ARMmbed/fpga-ci-test-shield-hardware/README.md

# FPGA CI Test shield - hardware design

Note: the RTL code for the FPGA lives in a separate repository: https://github.com/ARMmbed/fpga-ci-test-shield
