ARMmbed/fpga-ci-test-shield-hardware/doc/Documentation Slides.pptx

Upper position to run FPGA at 3V3. Lower position for 1.8V

Upper Position for USB,
Lower Position for External 5V

5 Jumpers fitted to supply power to the board

## Slide 2

3V3 Rail

1V0 Rail

1V8 Rail

## Slide 3

Jumper Positioning for External Programming

## Slide 4

Arduino Breakout board

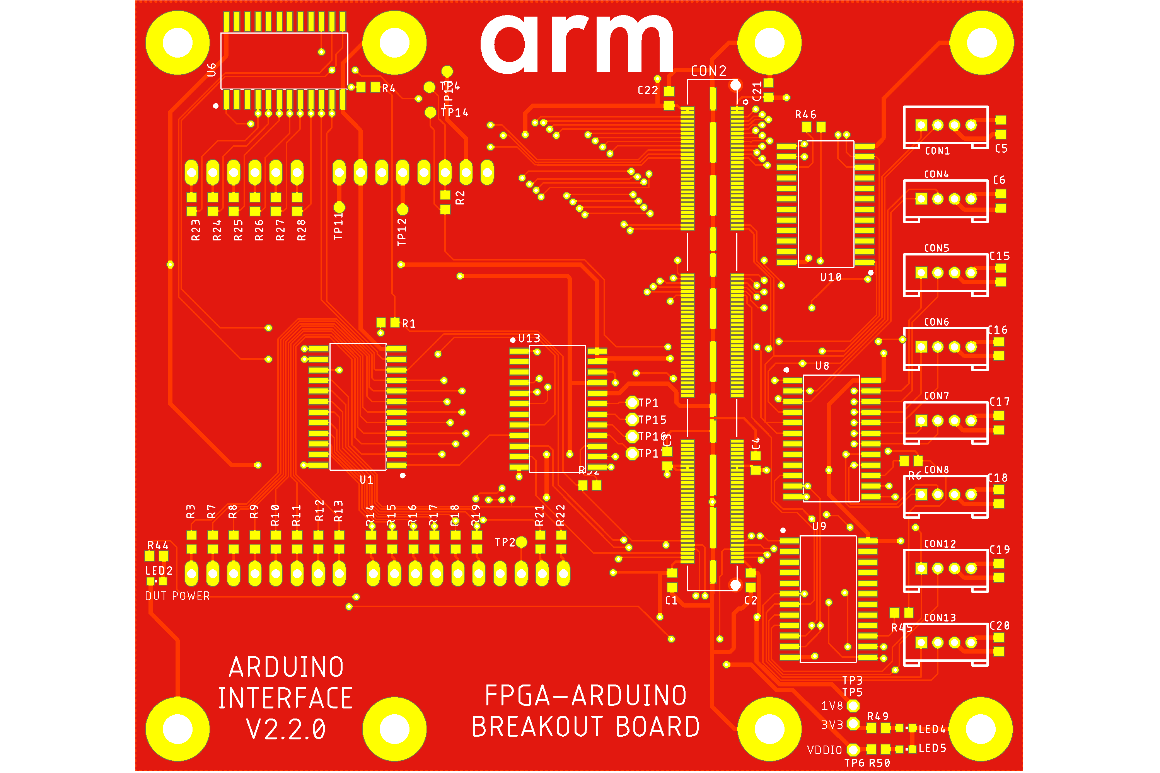
[picture p1: figure]

FPGA Board Interconnect

IO21
IO20
IO19
IO18
IO17
IO16

Arduino Form-Factor Pins (underside)

Grove connectors available for additional connectivity as required
(IO52 – IO64)

IO8
IO9
IO10
IO11
IO12
IO13
IO14
IO15

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
## Slide 5

Validation Board

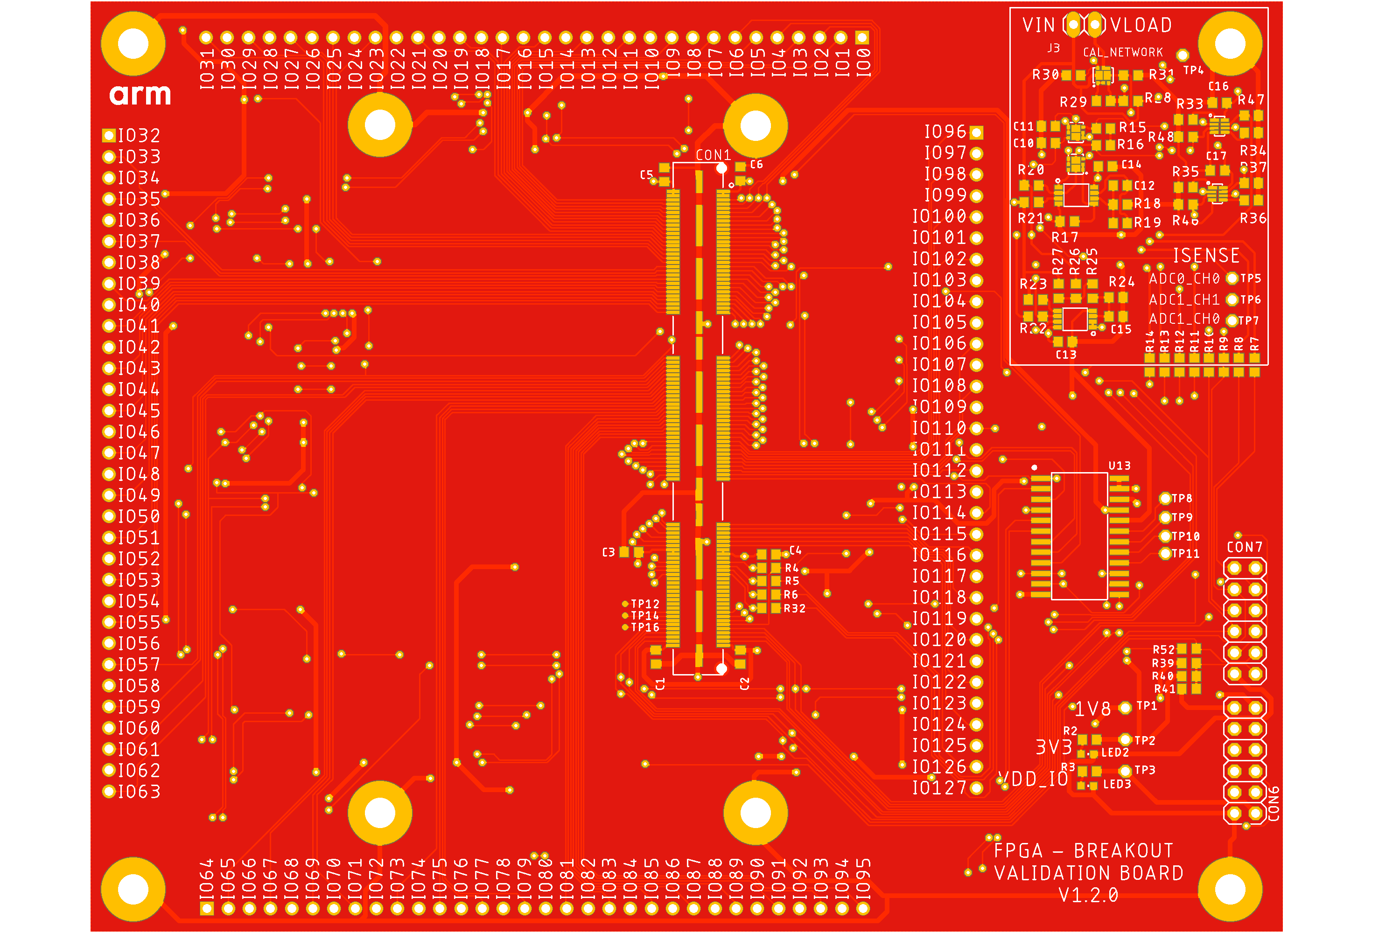
[picture p2: figure]

FPGA Board Interconnect

All IO brought out
to individual pins for monitoring and test

I Sense (for future development)

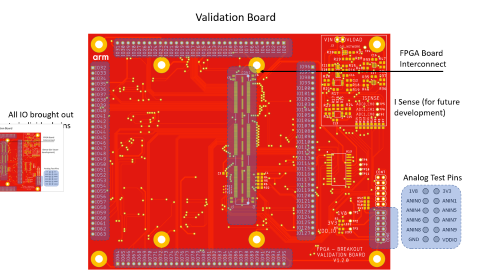
[picture p3: figure]

Analog Test Pins

ANIN0

1V8

ANIN1

3V3

ANIN4

ANIN6

ANIN8

ANIN5

ANIN7

ANIN9

GND

VDDIO
