ARMmbed/fpga-ci-test-shield-hardware/connectors/arduino/FPGA-ArduinoR3.brd

## EAGLE design connectors/arduino/FPGA-ArduinoR3.brd (2021-01-28)

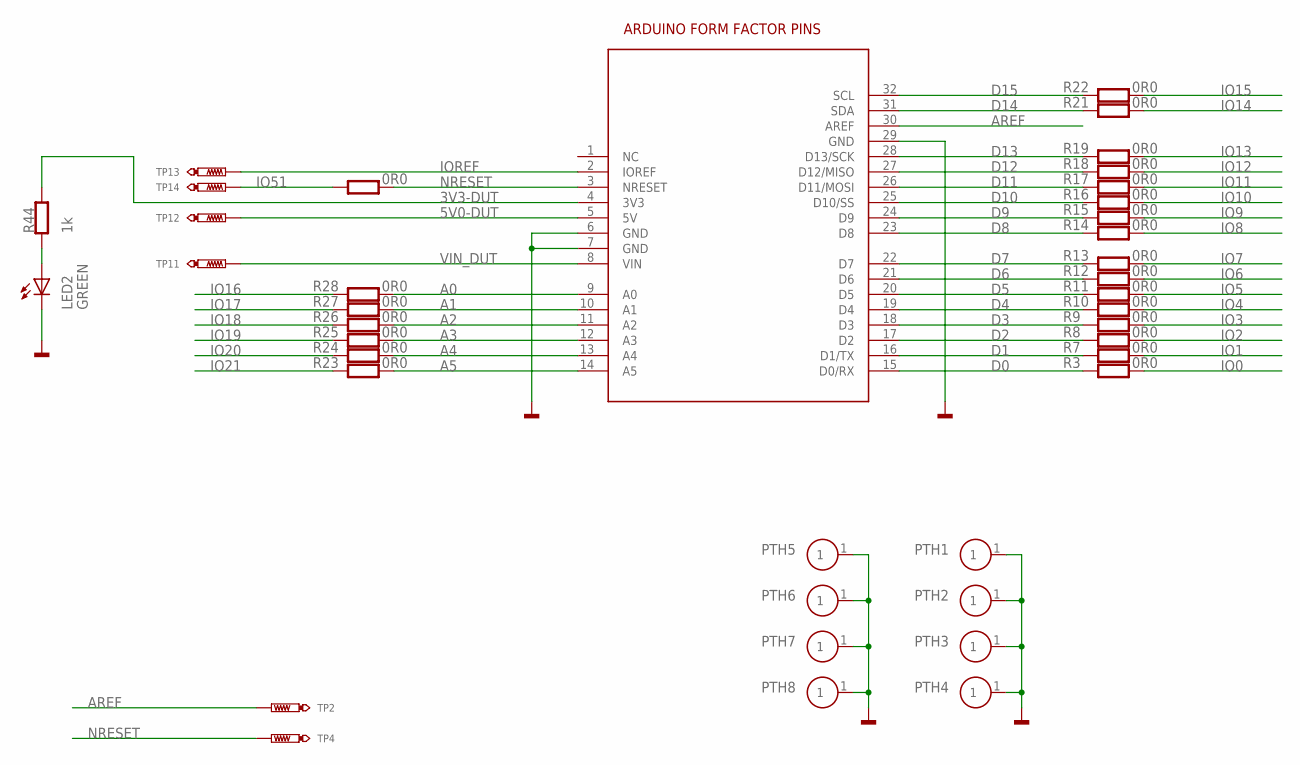
[picture p4: schematic FPGA-ArduinoR3.sch, sheet 1]

Parts:
BRD1: ARDUINO-R3_SILK; ARDUINO-R3-SILK
LED2: GREEN; CHIPLED_0603
PTH1, PTH2, PTH3, PTH4, PTH5, PTH6, PTH7, PTH8: FIXINGHOLE; PTH-140-300
R2, R3, R7, R8, R9, R10, R11, R12, R13, R14, R15, R16, R17, R18, R19, R21, R22, R23, R24, R25, R26, R27, R28: 0R0; 0603
R44: 1k; 0603
TP2, TP4, TP11, TP12, TP13, TP14: TEST_POINT-50R-SMD; TP50-SMD

Connections:
3V3-DUT: BRD1.4 (3V3), R44.2
5V0-DUT: BRD1.5 (5V), TP12.TP
A0: BRD1.9 (A0), R28.1
A1: BRD1.10 (A1), R27.1
A2: BRD1.11 (A2), R26.1
A3: BRD1.12 (A3), R25.1
A4: BRD1.13 (A4), R24.1
A5: BRD1.14 (A5), R23.1
AREF: BRD1.30 (AREF), TP2.TP
D0: BRD1.15 (D0/RX), R3.2
D1: BRD1.16 (D1/TX), R7.2
D2: BRD1.17 (D2), R8.2
D3: BRD1.18 (D3), R9.2
D4: BRD1.19 (D4), R10.2
D5: BRD1.20 (D5), R11.2
D6: BRD1.21 (D6), R12.2
D7: BRD1.22 (D7), R13.2
D8: BRD1.23 (D8), R14.2
D9: BRD1.24 (D9), R15.2
D10: BRD1.25 (D10/SS), R16.2
D11: BRD1.26 (D11/MOSI), R17.2
D12: BRD1.27 (D12/MISO), R18.2
D13: BRD1.28 (D13/SCK), R19.2
D14: BRD1.31 (SDA), R21.2
D15: BRD1.32 (SCL), R22.2
GND: BRD1.6 (GND), BRD1.7 (GND), BRD1.29 (GND), LED2.C, PTH1.1, PTH2.1, PTH3.1, PTH4.1, PTH5.1, PTH6.1, PTH7.1, PTH8.1; also elsewhere on the board
IO0: R3.1; also elsewhere on the board
IO1: R7.1; also elsewhere on the board
IO2: R8.1; also elsewhere on the board
IO3: R9.1; also elsewhere on the board
IO4: R10.1; also elsewhere on the board
IO5: R11.1; also elsewhere on the board
IO6: R12.1; also elsewhere on the board
IO7: R13.1; also elsewhere on the board
IO8: R14.1; also elsewhere on the board
IO9: R15.1; also elsewhere on the board
IO10: R16.1; also elsewhere on the board
IO11: R17.1; also elsewhere on the board
IO12: R18.1; also elsewhere on the board
IO13: R19.1; also elsewhere on the board
IO14: R21.1; also elsewhere on the board
IO15: R22.1; also elsewhere on the board
IO16: R28.2; also elsewhere on the board
IO17: R27.2; also elsewhere on the board
IO18: R26.2; also elsewhere on the board
IO19: R25.2; also elsewhere on the board
IO20: R24.2; also elsewhere on the board
IO21: R23.2; also elsewhere on the board
IO51: R2.2, TP14.TP; also elsewhere on the board
IOREF: BRD1.2 (IOREF), TP13.TP
unnamed: LED2.A, R44.1
NRESET: BRD1.3 (NRESET), R2.1, TP4.TP
VIN_DUT: BRD1.8 (VIN), TP11.TP

Notes on the sheet:
ARDUINO FORM FACTOR PINS

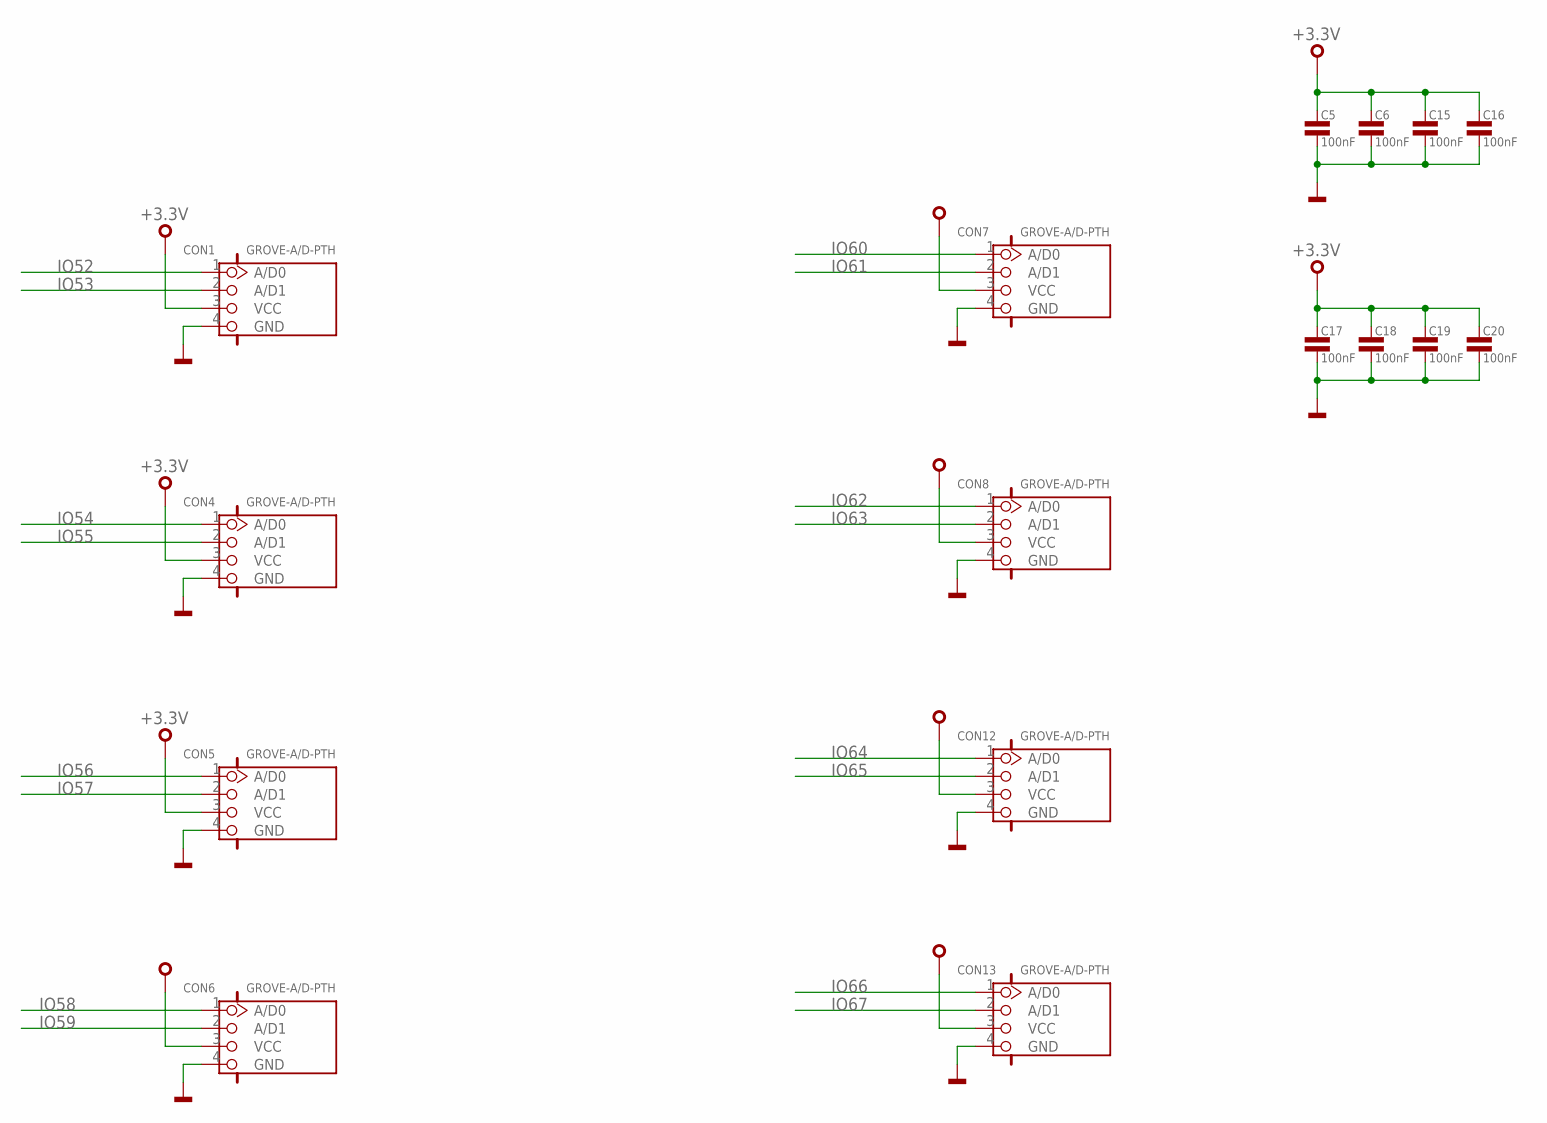
[picture p5: schematic FPGA-ArduinoR3.sch, sheet 2]

Parts:
C5, C6, C15, C16, C17, C18, C19, C20: 100nF; 0603
CON1, CON4, CON5, CON6, CON7, CON8, CON12, CON13: GROVE-A/D-PTH; HW4-2.0

Connections:
+3.3V: C5.1, C6.1, C15.1, C16.1, C17.1, C18.1, C19.1, C20.1, CON1.3 (VCC), CON4.3 (VCC), CON5.3 (VCC), CON6.3 (VCC), CON7.3 (VCC), CON8.3 (VCC), CON12.3 (VCC), CON13.3 (VCC); also elsewhere on the board
GND: C5.2, C6.2, C15.2, C16.2, C17.2, C18.2, C19.2, C20.2, CON1.4 (GND), CON4.4 (GND), CON5.4 (GND), CON6.4 (GND), CON7.4 (GND), CON8.4 (GND), CON12.4 (GND), CON13.4 (GND); also elsewhere on the board
IO52: CON1.1 (A/D0); also elsewhere on the board
IO53: CON1.2 (A/D1); also elsewhere on the board
IO54: CON4.1 (A/D0); also elsewhere on the board
IO55: CON4.2 (A/D1); also elsewhere on the board
IO56: CON5.1 (A/D0); also elsewhere on the board
IO57: CON5.2 (A/D1); also elsewhere on the board
IO58: CON6.1 (A/D0); also elsewhere on the board
IO59: CON6.2 (A/D1); also elsewhere on the board
IO60: CON7.1 (A/D0); also elsewhere on the board
IO61: CON7.2 (A/D1); also elsewhere on the board
IO62: CON8.1 (A/D0); also elsewhere on the board
IO63: CON8.2 (A/D1); also elsewhere on the board
IO64: CON12.1 (A/D0); also elsewhere on the board
IO65: CON12.2 (A/D1); also elsewhere on the board
IO66: CON13.1 (A/D0); also elsewhere on the board
IO67: CON13.2 (A/D1); also elsewhere on the board

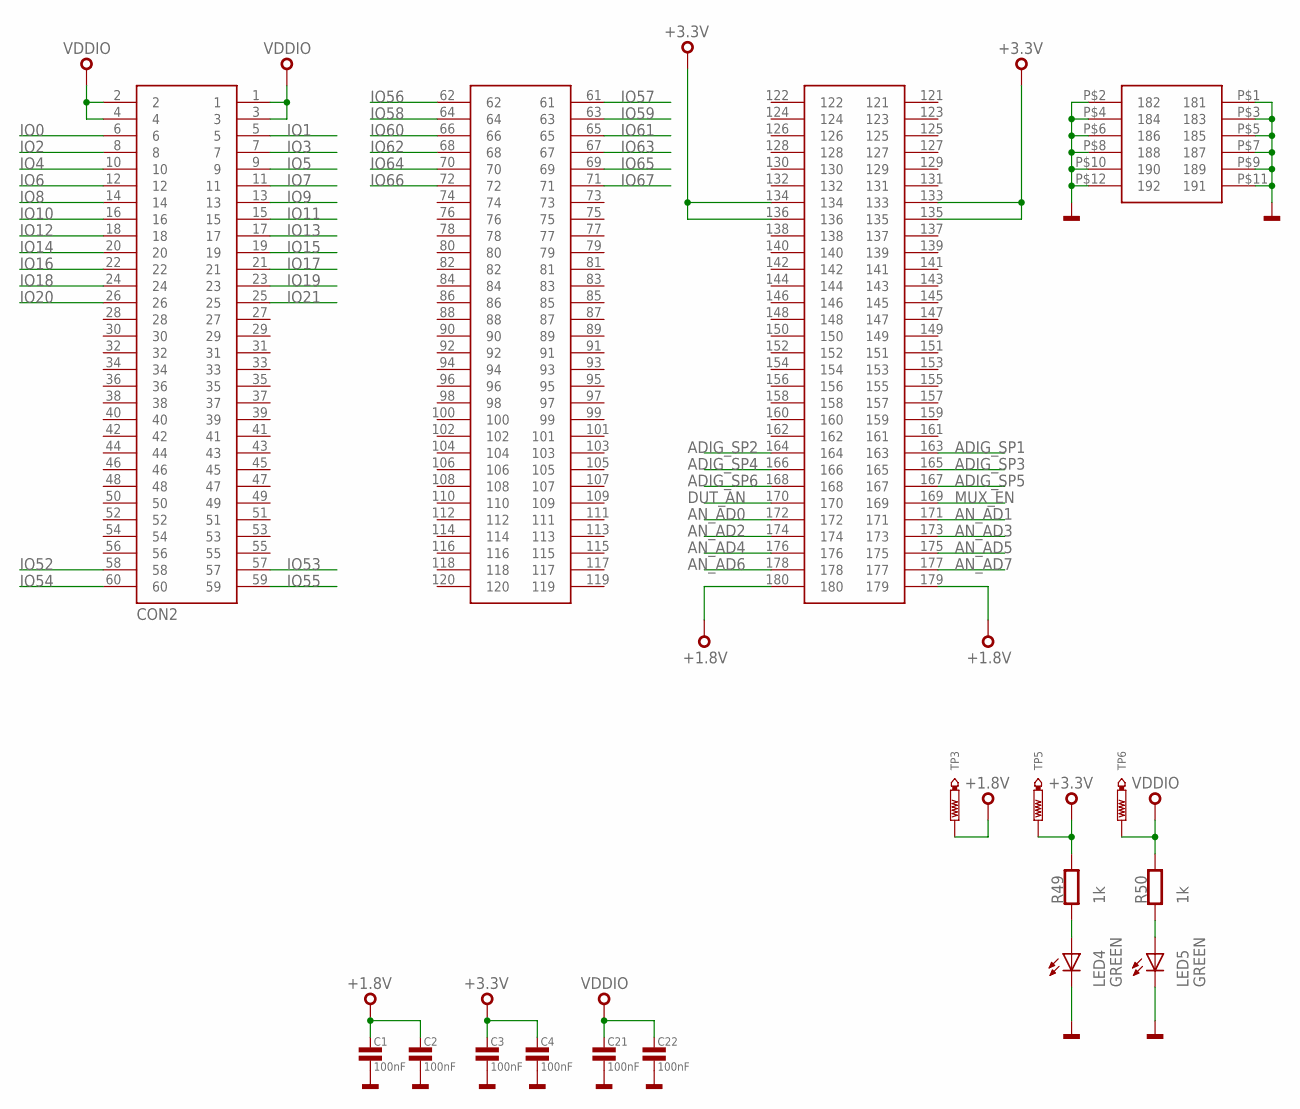
[picture p6: schematic FPGA-ArduinoR3.sch, sheet 3]

Parts:
C1, C2, C3, C4, C21, C22: 100nF; 0603
CON2: QSH-090-01-L-D-A
LED4, LED5: GREEN; CHIPLED_0603
R49, R50: 1k; 0603
TP3, TP5, TP6: TEST_POINT-50R-PTH; TP50-PTH

Connections:
+1.8V: C1.1, C2.1, CON2.179, CON2.180, TP3.TP; also elsewhere on the board
+3.3V: C3.1, C4.1, CON2.133, CON2.134, CON2.135, CON2.136, R49.2, TP5.TP; also elsewhere on the board
ADIG_SP1: CON2.163
ADIG_SP2: CON2.164
ADIG_SP3: CON2.165
ADIG_SP4: CON2.166
ADIG_SP5: CON2.167
ADIG_SP6: CON2.168
AN_AD0: CON2.172; also elsewhere on the board
AN_AD1: CON2.171; also elsewhere on the board
AN_AD2: CON2.174; also elsewhere on the board
AN_AD3: CON2.173; also elsewhere on the board
AN_AD4: CON2.176; also elsewhere on the board
AN_AD5: CON2.175; also elsewhere on the board
AN_AD6: CON2.178; also elsewhere on the board
AN_AD7: CON2.177; also elsewhere on the board
DUT_AN: CON2.170; also elsewhere on the board
GND: C1.2, C2.2, C3.2, C4.2, C21.2, C22.2, CON2.P$1 (181), CON2.P$2 (182), CON2.P$3 (183), CON2.P$4 (184), CON2.P$5 (185), CON2.P$6 (186), CON2.P$7 (187), CON2.P$8 (188), CON2.P$9 (189), CON2.P$10 (190), CON2.P$11 (191), CON2.P$12 (192), LED4.C, LED5.C; also elsewhere on the board
IO0: CON2.6; also elsewhere on the board
IO1: CON2.5; also elsewhere on the board
IO2: CON2.8; also elsewhere on the board
IO3: CON2.7; also elsewhere on the board
IO4: CON2.10; also elsewhere on the board
IO5: CON2.9; also elsewhere on the board
IO6: CON2.12; also elsewhere on the board
IO7: CON2.11; also elsewhere on the board
IO8: CON2.14; also elsewhere on the board
IO9: CON2.13; also elsewhere on the board
IO10: CON2.16; also elsewhere on the board
IO11: CON2.15; also elsewhere on the board
IO12: CON2.18; also elsewhere on the board
IO13: CON2.17; also elsewhere on the board
IO14: CON2.20; also elsewhere on the board
IO15: CON2.19; also elsewhere on the board
IO16: CON2.22; also elsewhere on the board
IO17: CON2.21; also elsewhere on the board
IO18: CON2.24; also elsewhere on the board
IO19: CON2.23; also elsewhere on the board
IO20: CON2.26; also elsewhere on the board
IO21: CON2.25; also elsewhere on the board
IO52: CON2.58; also elsewhere on the board
IO53: CON2.57; also elsewhere on the board
IO54: CON2.60; also elsewhere on the board
IO55: CON2.59; also elsewhere on the board
IO56: CON2.62; also elsewhere on the board
IO57: CON2.61; also elsewhere on the board
IO58: CON2.64; also elsewhere on the board
IO59: CON2.63; also elsewhere on the board
IO60: CON2.66; also elsewhere on the board
IO61: CON2.65; also elsewhere on the board
IO62: CON2.68; also elsewhere on the board
IO63: CON2.67; also elsewhere on the board
IO64: CON2.70; also elsewhere on the board
IO65: CON2.69; also elsewhere on the board
IO66: CON2.72; also elsewhere on the board
IO67: CON2.71; also elsewhere on the board
MUX_EN: CON2.169; also elsewhere on the board
unnamed: LED4.A, R49.1
unnamed: LED5.A, R50.1
VDDIO: C21.1, C22.1, CON2.1, CON2.2, CON2.3, CON2.4, R50.2, TP6.TP; also elsewhere on the board

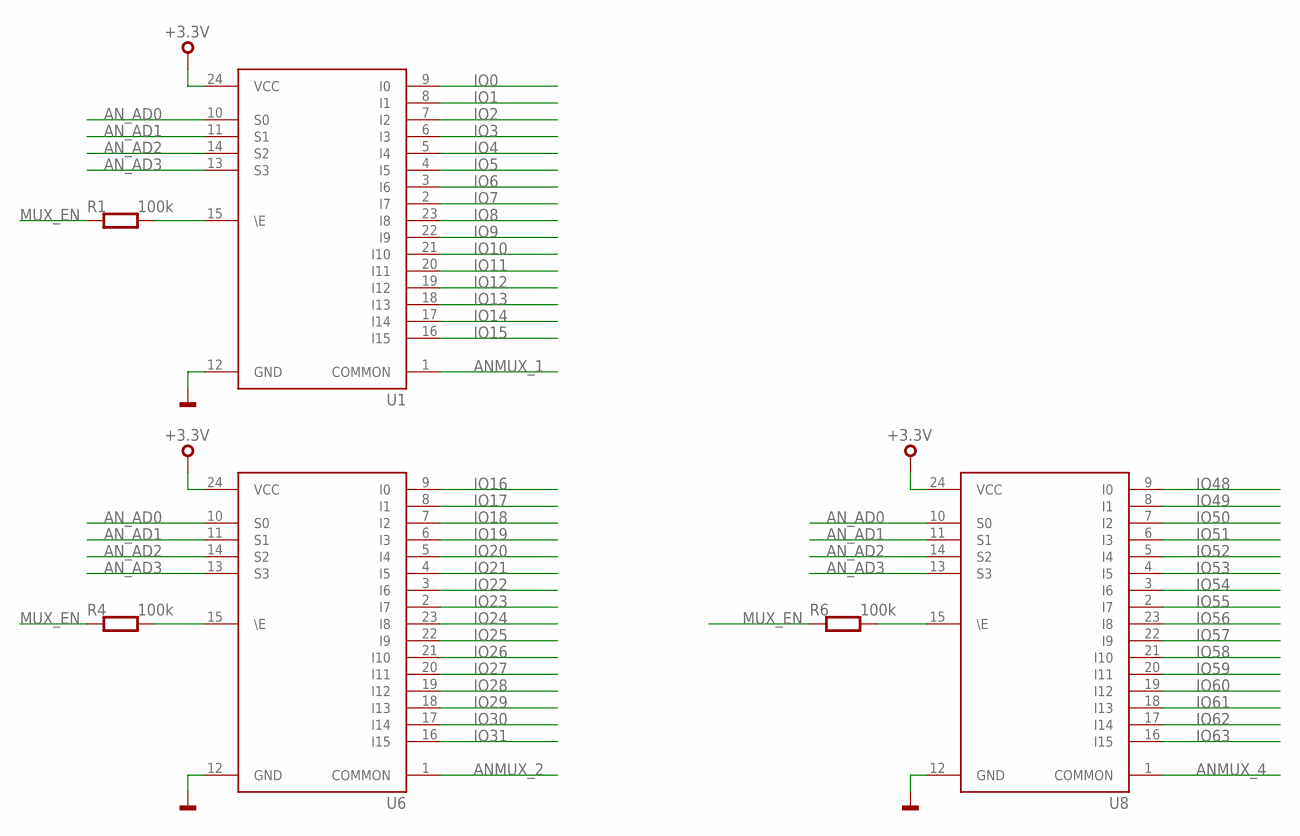
[picture p7: schematic FPGA-ArduinoR3.sch, sheet 4]

Parts:
R1, R4, R6: 100k; 0603
U1, U6, U8: CD74HCT4067; SO24

Connections:
+3.3V: U1.24 (VCC), U6.24 (VCC), U8.24 (VCC); also elsewhere on the board
ANMUX_1: U1.1 (COMMON); also elsewhere on the board
ANMUX_2: U6.1 (COMMON); also elsewhere on the board
ANMUX_4: U8.1 (COMMON); also elsewhere on the board
AN_AD0: U1.10 (S0), U6.10 (S0), U8.10 (S0); also elsewhere on the board
AN_AD1: U1.11 (S1), U6.11 (S1), U8.11 (S1); also elsewhere on the board
AN_AD2: U1.14 (S2), U6.14 (S2), U8.14 (S2); also elsewhere on the board
AN_AD3: U1.13 (S3), U6.13 (S3), U8.13 (S3); also elsewhere on the board
GND: U1.12 (GND), U6.12 (GND), U8.12 (GND); also elsewhere on the board
IO0: U1.9 (I0); also elsewhere on the board
IO1: U1.8 (I1); also elsewhere on the board
IO2: U1.7 (I2); also elsewhere on the board
IO3: U1.6 (I3); also elsewhere on the board
IO4: U1.5 (I4); also elsewhere on the board
IO5: U1.4 (I5); also elsewhere on the board
IO6: U1.3 (I6); also elsewhere on the board
IO7: U1.2 (I7); also elsewhere on the board
IO8: U1.23 (I8); also elsewhere on the board
IO9: U1.22 (I9); also elsewhere on the board
IO10: U1.21 (I10); also elsewhere on the board
IO11: U1.20 (I11); also elsewhere on the board
IO12: U1.19 (I12); also elsewhere on the board
IO13: U1.18 (I13); also elsewhere on the board
IO14: U1.17 (I14); also elsewhere on the board
IO15: U1.16 (I15); also elsewhere on the board
IO16: U6.9 (I0); also elsewhere on the board
IO17: U6.8 (I1); also elsewhere on the board
IO18: U6.7 (I2); also elsewhere on the board
IO19: U6.6 (I3); also elsewhere on the board
IO20: U6.5 (I4); also elsewhere on the board
IO21: U6.4 (I5); also elsewhere on the board
IO22: U6.3 (I6)
IO23: U6.2 (I7)
IO24: U6.23 (I8)
IO25: U6.22 (I9)
IO26: U6.21 (I10)
IO27: U6.20 (I11)
IO28: U6.19 (I12)
IO29: U6.18 (I13)
IO30: U6.17 (I14)
IO31: U6.16 (I15)
IO48: U8.9 (I0)
IO49: U8.8 (I1)
IO50: U8.7 (I2)
IO51: U8.6 (I3); also elsewhere on the board
IO52: U8.5 (I4); also elsewhere on the board
IO53: U8.4 (I5); also elsewhere on the board
IO54: U8.3 (I6); also elsewhere on the board
IO55: U8.2 (I7); also elsewhere on the board
IO56: U8.23 (I8); also elsewhere on the board
IO57: U8.22 (I9); also elsewhere on the board
IO58: U8.21 (I10); also elsewhere on the board
IO59: U8.20 (I11); also elsewhere on the board
IO60: U8.19 (I12); also elsewhere on the board
IO61: U8.18 (I13); also elsewhere on the board
IO62: U8.17 (I14); also elsewhere on the board
IO63: U8.16 (I15); also elsewhere on the board
MUX_EN: R1.1, R4.1, R6.1; also elsewhere on the board
unnamed: R4.2, U6.15 (\E)
unnamed: R1.2, U1.15 (\E)
unnamed: R6.2, U8.15 (\E)

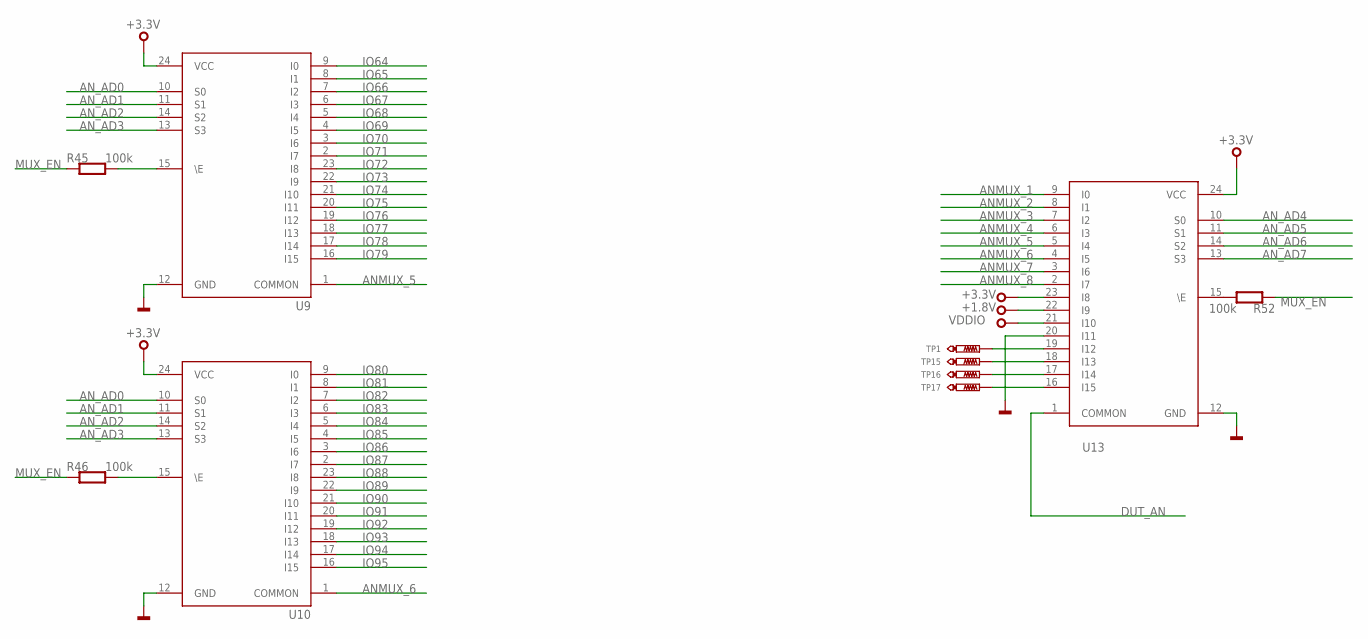
[picture p8: schematic FPGA-ArduinoR3.sch, sheet 5]

Parts:
R45, R46, R52: 100k; 0603
TP1, TP15, TP16, TP17: TEST_POINT-50R-PTH; TP50-PTH
U9, U10, U13: CD74HCT4067; SO24

Connections:
+1.8V: U13.22 (I9); also elsewhere on the board
+3.3V: U9.24 (VCC), U10.24 (VCC), U13.23 (I8), U13.24 (VCC); also elsewhere on the board
ANMUX_1: U13.9 (I0); also elsewhere on the board
ANMUX_2: U13.8 (I1); also elsewhere on the board
ANMUX_3: U13.7 (I2)
ANMUX_4: U13.6 (I3); also elsewhere on the board
ANMUX_5: U9.1 (COMMON), U13.5 (I4)
ANMUX_6: U10.1 (COMMON), U13.4 (I5)
ANMUX_7: U13.3 (I6)
ANMUX_8: U13.2 (I7)
AN_AD0: U9.10 (S0), U10.10 (S0); also elsewhere on the board
AN_AD1: U9.11 (S1), U10.11 (S1); also elsewhere on the board
AN_AD2: U9.14 (S2), U10.14 (S2); also elsewhere on the board
AN_AD3: U9.13 (S3), U10.13 (S3); also elsewhere on the board
AN_AD4: U13.10 (S0); also elsewhere on the board
AN_AD5: U13.11 (S1); also elsewhere on the board
AN_AD6: U13.14 (S2); also elsewhere on the board
AN_AD7: U13.13 (S3); also elsewhere on the board
DUT_AN: U13.1 (COMMON); also elsewhere on the board
GND: U9.12 (GND), U10.12 (GND), U13.12 (GND), U13.20 (I11); also elsewhere on the board
IO64: U9.9 (I0); also elsewhere on the board
IO65: U9.8 (I1); also elsewhere on the board
IO66: U9.7 (I2); also elsewhere on the board
IO67: U9.6 (I3); also elsewhere on the board
IO68: U9.5 (I4)
IO69: U9.4 (I5)
IO70: U9.3 (I6)
IO71: U9.2 (I7)
IO72: U9.23 (I8)
IO73: U9.22 (I9)
IO74: U9.21 (I10)
IO75: U9.20 (I11)
IO76: U9.19 (I12)
IO77: U9.18 (I13)
IO78: U9.17 (I14)
IO79: U9.16 (I15)
IO80: U10.9 (I0)
IO81: U10.8 (I1)
IO82: U10.7 (I2)
IO83: U10.6 (I3)
IO84: U10.5 (I4)
IO85: U10.4 (I5)
IO86: U10.3 (I6)
IO87: U10.2 (I7)
IO88: U10.23 (I8)
IO89: U10.22 (I9)
IO90: U10.21 (I10)
IO91: U10.20 (I11)
IO92: U10.19 (I12)
IO93: U10.18 (I13)
IO94: U10.17 (I14)
IO95: U10.16 (I15)
MUX_EN: R45.1, R46.1, R52.1; also elsewhere on the board
unnamed: R45.2, U9.15 (\E)
unnamed: R46.2, U10.15 (\E)
unnamed: R52.2, U13.15 (\E)
unnamed: TP1.TP, U13.19 (I12)
unnamed: TP15.TP, U13.18 (I13)
unnamed: TP16.TP, U13.17 (I14)
unnamed: TP17.TP, U13.16 (I15)
VDDIO: U13.21 (I10); also elsewhere on the board

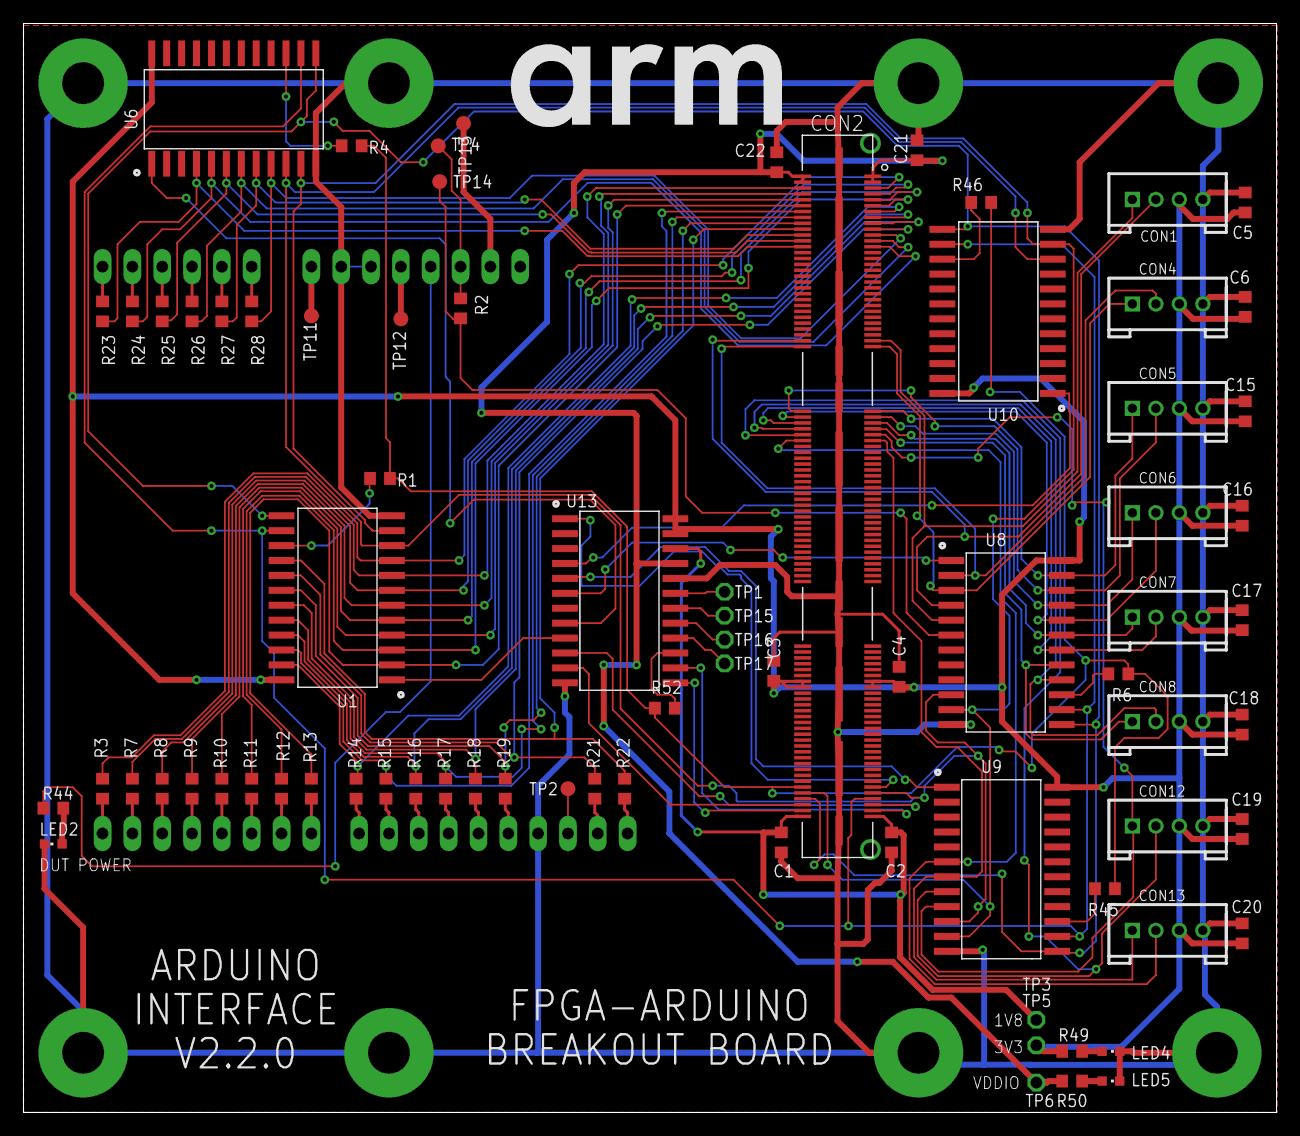
[picture p9: board FPGA-ArduinoR3.brd from above]

Board: 2 copper layers, 106.7 x 92.7 mm, 86 parts (0 on the bottom side), 99 nets.
