ARMmbed/fpga-ci-test-shield-hardware/mainboard/FPGA-Validation.brd

## EAGLE design mainboard/FPGA-Validation.brd (2021-01-28)

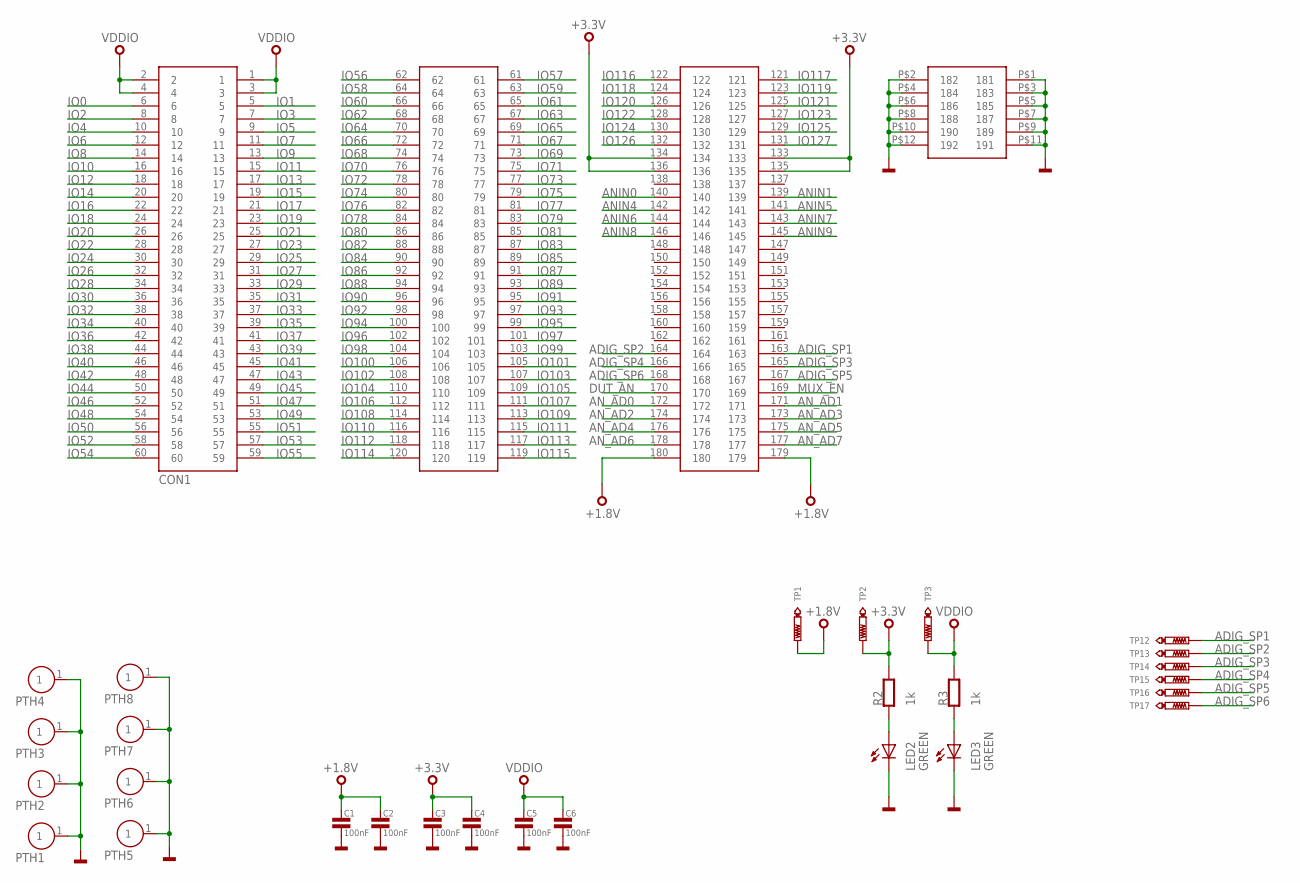
[picture p10: schematic FPGA-Validation.sch, sheet 1]

Parts:
C1, C2, C3, C4, C5, C6: 100nF; 0603
CON1: QSH-090-01-L-D-A
LED2, LED3: GREEN; CHIPLED_0603
PTH1, PTH2, PTH3, PTH4, PTH5, PTH6, PTH7, PTH8: FIXINGHOLE; PTH-140-300
R2, R3: 1k; 0603
TP1, TP2, TP3: TEST_POINT-50R-PTH; TP50-PTH
TP12, TP13, TP14, TP15, TP16, TP17: TEST_POINT-25R-SMD; TP25-SMD

Connections:
+1.8V: C1.1, C2.1, CON1.179, CON1.180, TP1.TP; also elsewhere on the board
+3.3V: C3.1, C4.1, CON1.133, CON1.134, CON1.135, CON1.136, R2.2, TP2.TP; also elsewhere on the board
ADIG_SP1: CON1.163, TP12.TP
ADIG_SP2: CON1.164, TP13.TP
ADIG_SP3: CON1.165, TP14.TP
ADIG_SP4: CON1.166, TP15.TP
ADIG_SP5: CON1.167, TP16.TP
ADIG_SP6: CON1.168, TP17.TP
ANIN0: CON1.140; also elsewhere on the board
ANIN1: CON1.139; also elsewhere on the board
ANIN4: CON1.142; also elsewhere on the board
ANIN5: CON1.141; also elsewhere on the board
ANIN6: CON1.144; also elsewhere on the board
ANIN7: CON1.143; also elsewhere on the board
ANIN8: CON1.146; also elsewhere on the board
ANIN9: CON1.145; also elsewhere on the board
AN_AD0: CON1.172; also elsewhere on the board
AN_AD1: CON1.171; also elsewhere on the board
AN_AD2: CON1.174; also elsewhere on the board
AN_AD3: CON1.173; also elsewhere on the board
AN_AD4: CON1.176; also elsewhere on the board
AN_AD5: CON1.175; also elsewhere on the board
AN_AD6: CON1.178; also elsewhere on the board
AN_AD7: CON1.177; also elsewhere on the board
DUT_AN: CON1.170; also elsewhere on the board
GND: C1.2, C2.2, C3.2, C4.2, C5.2, C6.2, CON1.P$1 (181), CON1.P$2 (182), CON1.P$3 (183), CON1.P$4 (184), CON1.P$5 (185), CON1.P$6 (186), CON1.P$7 (187), CON1.P$8 (188), CON1.P$9 (189), CON1.P$10 (190), CON1.P$11 (191), CON1.P$12 (192), LED2.C, LED3.C, PTH1.1, PTH2.1, PTH3.1, PTH4.1, PTH5.1, PTH6.1, PTH7.1, PTH8.1; also elsewhere on the board
IO0: CON1.6; also elsewhere on the board
IO1: CON1.5; also elsewhere on the board
IO2: CON1.8; also elsewhere on the board
IO3: CON1.7; also elsewhere on the board
IO4: CON1.10; also elsewhere on the board
IO5: CON1.9; also elsewhere on the board
IO6: CON1.12; also elsewhere on the board
IO7: CON1.11; also elsewhere on the board
IO8: CON1.14; also elsewhere on the board
IO9: CON1.13; also elsewhere on the board
IO10: CON1.16; also elsewhere on the board
IO11: CON1.15; also elsewhere on the board
IO12: CON1.18; also elsewhere on the board
IO13: CON1.17; also elsewhere on the board
IO14: CON1.20; also elsewhere on the board
IO15: CON1.19; also elsewhere on the board
IO16: CON1.22; also elsewhere on the board
IO17: CON1.21; also elsewhere on the board
IO18: CON1.24; also elsewhere on the board
IO19: CON1.23; also elsewhere on the board
IO20: CON1.26; also elsewhere on the board
IO21: CON1.25; also elsewhere on the board
IO22: CON1.28; also elsewhere on the board
IO23: CON1.27; also elsewhere on the board
IO24: CON1.30; also elsewhere on the board
IO25: CON1.29; also elsewhere on the board
IO26: CON1.32; also elsewhere on the board
IO27: CON1.31; also elsewhere on the board
IO28: CON1.34; also elsewhere on the board
IO29: CON1.33; also elsewhere on the board
IO30: CON1.36; also elsewhere on the board
IO31: CON1.35; also elsewhere on the board
IO32: CON1.38; also elsewhere on the board
IO33: CON1.37; also elsewhere on the board
IO34: CON1.40; also elsewhere on the board
IO35: CON1.39; also elsewhere on the board
IO36: CON1.42; also elsewhere on the board
IO37: CON1.41; also elsewhere on the board
IO38: CON1.44; also elsewhere on the board
IO39: CON1.43; also elsewhere on the board
IO40: CON1.46; also elsewhere on the board
IO41: CON1.45; also elsewhere on the board
IO42: CON1.48; also elsewhere on the board
IO43: CON1.47; also elsewhere on the board
IO44: CON1.50; also elsewhere on the board
IO45: CON1.49; also elsewhere on the board
IO46: CON1.52; also elsewhere on the board
IO47: CON1.51; also elsewhere on the board
IO48: CON1.54; also elsewhere on the board
IO49: CON1.53; also elsewhere on the board
IO50: CON1.56; also elsewhere on the board
IO51: CON1.55; also elsewhere on the board
IO52: CON1.58; also elsewhere on the board
IO53: CON1.57; also elsewhere on the board
IO54: CON1.60; also elsewhere on the board
IO55: CON1.59; also elsewhere on the board
IO56: CON1.62; also elsewhere on the board
IO57: CON1.61; also elsewhere on the board
IO58: CON1.64; also elsewhere on the board
IO59: CON1.63; also elsewhere on the board
IO60: CON1.66; also elsewhere on the board
IO61: CON1.65; also elsewhere on the board
IO62: CON1.68; also elsewhere on the board
IO63: CON1.67; also elsewhere on the board
IO64: CON1.70; also elsewhere on the board
IO65: CON1.69; also elsewhere on the board
IO66: CON1.72; also elsewhere on the board
IO67: CON1.71; also elsewhere on the board
IO68: CON1.74; also elsewhere on the board
IO69: CON1.73; also elsewhere on the board
IO70: CON1.76; also elsewhere on the board
IO71: CON1.75; also elsewhere on the board
IO72: CON1.78; also elsewhere on the board
IO73: CON1.77; also elsewhere on the board
IO74: CON1.80; also elsewhere on the board
IO75: CON1.79; also elsewhere on the board
IO76: CON1.82; also elsewhere on the board
IO77: CON1.81; also elsewhere on the board
IO78: CON1.84; also elsewhere on the board
IO79: CON1.83; also elsewhere on the board
IO80: CON1.86; also elsewhere on the board
IO81: CON1.85; also elsewhere on the board
IO82: CON1.88; also elsewhere on the board
IO83: CON1.87; also elsewhere on the board
IO84: CON1.90; also elsewhere on the board
IO85: CON1.89; also elsewhere on the board
IO86: CON1.92; also elsewhere on the board
IO87: CON1.91; also elsewhere on the board
IO88: CON1.94; also elsewhere on the board
IO89: CON1.93; also elsewhere on the board
IO90: CON1.96; also elsewhere on the board
IO91: CON1.95; also elsewhere on the board
IO92: CON1.98; also elsewhere on the board
IO93: CON1.97; also elsewhere on the board
IO94: CON1.100; also elsewhere on the board
IO95: CON1.99; also elsewhere on the board
IO96: CON1.102; also elsewhere on the board
IO97: CON1.101; also elsewhere on the board
IO98: CON1.104; also elsewhere on the board
IO99: CON1.103; also elsewhere on the board
IO100: CON1.106; also elsewhere on the board
IO101: CON1.105; also elsewhere on the board
IO102: CON1.108; also elsewhere on the board
IO103: CON1.107; also elsewhere on the board
IO104: CON1.110; also elsewhere on the board
IO105: CON1.109; also elsewhere on the board
IO106: CON1.112; also elsewhere on the board
IO107: CON1.111; also elsewhere on the board
IO108: CON1.114; also elsewhere on the board
IO109: CON1.113; also elsewhere on the board
IO110: CON1.116; also elsewhere on the board
IO111: CON1.115; also elsewhere on the board
IO112: CON1.118; also elsewhere on the board
IO113: CON1.117; also elsewhere on the board
IO114: CON1.120; also elsewhere on the board
IO115: CON1.119; also elsewhere on the board
IO116: CON1.122; also elsewhere on the board
IO117: CON1.121; also elsewhere on the board
IO118: CON1.124; also elsewhere on the board
IO119: CON1.123; also elsewhere on the board
IO120: CON1.126; also elsewhere on the board
IO121: CON1.125; also elsewhere on the board
IO122: CON1.128; also elsewhere on the board
IO123: CON1.127; also elsewhere on the board
IO124: CON1.130; also elsewhere on the board
IO125: CON1.129; also elsewhere on the board
IO126: CON1.132; also elsewhere on the board
IO127: CON1.131; also elsewhere on the board
MUX_EN: CON1.169; also elsewhere on the board
unnamed: LED3.A, R3.1
unnamed: LED2.A, R2.1
VDDIO: C5.1, C6.1, CON1.1, CON1.2, CON1.3, CON1.4, R3.2, TP3.TP; also elsewhere on the board
