ARMmbed/fpga-ci-test-shield-hardware/mainboard/FPGA-Validation.brd

## EAGLE design mainboard/FPGA-Validation.brd (continued)

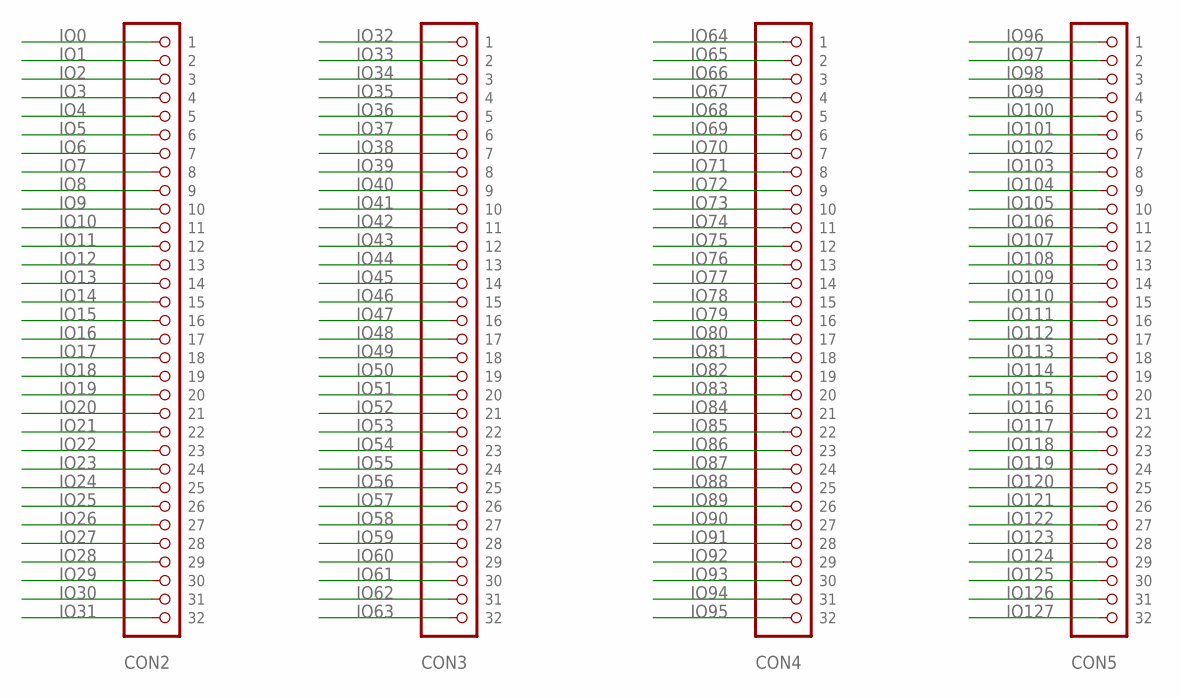
[picture p11: schematic FPGA-Validation.sch, sheet 2]

Parts:
CON2, CON3, CON4, CON5: PINHD-1X32; 1X32

Connections:
IO0: CON2.1; also elsewhere on the board
IO1: CON2.2; also elsewhere on the board
IO2: CON2.3; also elsewhere on the board
IO3: CON2.4; also elsewhere on the board
IO4: CON2.5; also elsewhere on the board
IO5: CON2.6; also elsewhere on the board
IO6: CON2.7; also elsewhere on the board
IO7: CON2.8; also elsewhere on the board
IO8: CON2.9; also elsewhere on the board
IO9: CON2.10; also elsewhere on the board
IO10: CON2.11; also elsewhere on the board
IO11: CON2.12; also elsewhere on the board
IO12: CON2.13; also elsewhere on the board
IO13: CON2.14; also elsewhere on the board
IO14: CON2.15; also elsewhere on the board
IO15: CON2.16; also elsewhere on the board
IO16: CON2.17; also elsewhere on the board
IO17: CON2.18; also elsewhere on the board
IO18: CON2.19; also elsewhere on the board
IO19: CON2.20; also elsewhere on the board
IO20: CON2.21; also elsewhere on the board
IO21: CON2.22; also elsewhere on the board
IO22: CON2.23; also elsewhere on the board
IO23: CON2.24; also elsewhere on the board
IO24: CON2.25; also elsewhere on the board
IO25: CON2.26; also elsewhere on the board
IO26: CON2.27; also elsewhere on the board
IO27: CON2.28; also elsewhere on the board
IO28: CON2.29; also elsewhere on the board
IO29: CON2.30; also elsewhere on the board
IO30: CON2.31; also elsewhere on the board
IO31: CON2.32; also elsewhere on the board
IO32: CON3.1; also elsewhere on the board
IO33: CON3.2; also elsewhere on the board
IO34: CON3.3; also elsewhere on the board
IO35: CON3.4; also elsewhere on the board
IO36: CON3.5; also elsewhere on the board
IO37: CON3.6; also elsewhere on the board
IO38: CON3.7; also elsewhere on the board
IO39: CON3.8; also elsewhere on the board
IO40: CON3.9; also elsewhere on the board
IO41: CON3.10; also elsewhere on the board
IO42: CON3.11; also elsewhere on the board
IO43: CON3.12; also elsewhere on the board
IO44: CON3.13; also elsewhere on the board
IO45: CON3.14; also elsewhere on the board
IO46: CON3.15; also elsewhere on the board
IO47: CON3.16; also elsewhere on the board
IO48: CON3.17; also elsewhere on the board
IO49: CON3.18; also elsewhere on the board
IO50: CON3.19; also elsewhere on the board
IO51: CON3.20; also elsewhere on the board
IO52: CON3.21; also elsewhere on the board
IO53: CON3.22; also elsewhere on the board
IO54: CON3.23; also elsewhere on the board
IO55: CON3.24; also elsewhere on the board
IO56: CON3.25; also elsewhere on the board
IO57: CON3.26; also elsewhere on the board
IO58: CON3.27; also elsewhere on the board
IO59: CON3.28; also elsewhere on the board
IO60: CON3.29; also elsewhere on the board
IO61: CON3.30; also elsewhere on the board
IO62: CON3.31; also elsewhere on the board
IO63: CON3.32; also elsewhere on the board
IO64: CON4.1; also elsewhere on the board
IO65: CON4.2; also elsewhere on the board
IO66: CON4.3; also elsewhere on the board
IO67: CON4.4; also elsewhere on the board
IO68: CON4.5; also elsewhere on the board
IO69: CON4.6; also elsewhere on the board
IO70: CON4.7; also elsewhere on the board
IO71: CON4.8; also elsewhere on the board
IO72: CON4.9; also elsewhere on the board
IO73: CON4.10; also elsewhere on the board
IO74: CON4.11; also elsewhere on the board
IO75: CON4.12; also elsewhere on the board
IO76: CON4.13; also elsewhere on the board
IO77: CON4.14; also elsewhere on the board
IO78: CON4.15; also elsewhere on the board
IO79: CON4.16; also elsewhere on the board
IO80: CON4.17; also elsewhere on the board
IO81: CON4.18; also elsewhere on the board
IO82: CON4.19; also elsewhere on the board
IO83: CON4.20; also elsewhere on the board
IO84: CON4.21; also elsewhere on the board
IO85: CON4.22; also elsewhere on the board
IO86: CON4.23; also elsewhere on the board
IO87: CON4.24; also elsewhere on the board
IO88: CON4.25; also elsewhere on the board
IO89: CON4.26; also elsewhere on the board
IO90: CON4.27; also elsewhere on the board
IO91: CON4.28; also elsewhere on the board
IO92: CON4.29; also elsewhere on the board
IO93: CON4.30; also elsewhere on the board
IO94: CON4.31; also elsewhere on the board
IO95: CON4.32; also elsewhere on the board
IO96: CON5.1; also elsewhere on the board
IO97: CON5.2; also elsewhere on the board
IO98: CON5.3; also elsewhere on the board
IO99: CON5.4; also elsewhere on the board
IO100: CON5.5; also elsewhere on the board
IO101: CON5.6; also elsewhere on the board
IO102: CON5.7; also elsewhere on the board
IO103: CON5.8; also elsewhere on the board
IO104: CON5.9; also elsewhere on the board
IO105: CON5.10; also elsewhere on the board
IO106: CON5.11; also elsewhere on the board
IO107: CON5.12; also elsewhere on the board
IO108: CON5.13; also elsewhere on the board
IO109: CON5.14; also elsewhere on the board
IO110: CON5.15; also elsewhere on the board
IO111: CON5.16; also elsewhere on the board
IO112: CON5.17; also elsewhere on the board
IO113: CON5.18; also elsewhere on the board
IO114: CON5.19; also elsewhere on the board
IO115: CON5.20; also elsewhere on the board
IO116: CON5.21; also elsewhere on the board
IO117: CON5.22; also elsewhere on the board
IO118: CON5.23; also elsewhere on the board
IO119: CON5.24; also elsewhere on the board
IO120: CON5.25; also elsewhere on the board
IO121: CON5.26; also elsewhere on the board
IO122: CON5.27; also elsewhere on the board
IO123: CON5.28; also elsewhere on the board
IO124: CON5.29; also elsewhere on the board
IO125: CON5.30; also elsewhere on the board
IO126: CON5.31; also elsewhere on the board
IO127: CON5.32; also elsewhere on the board

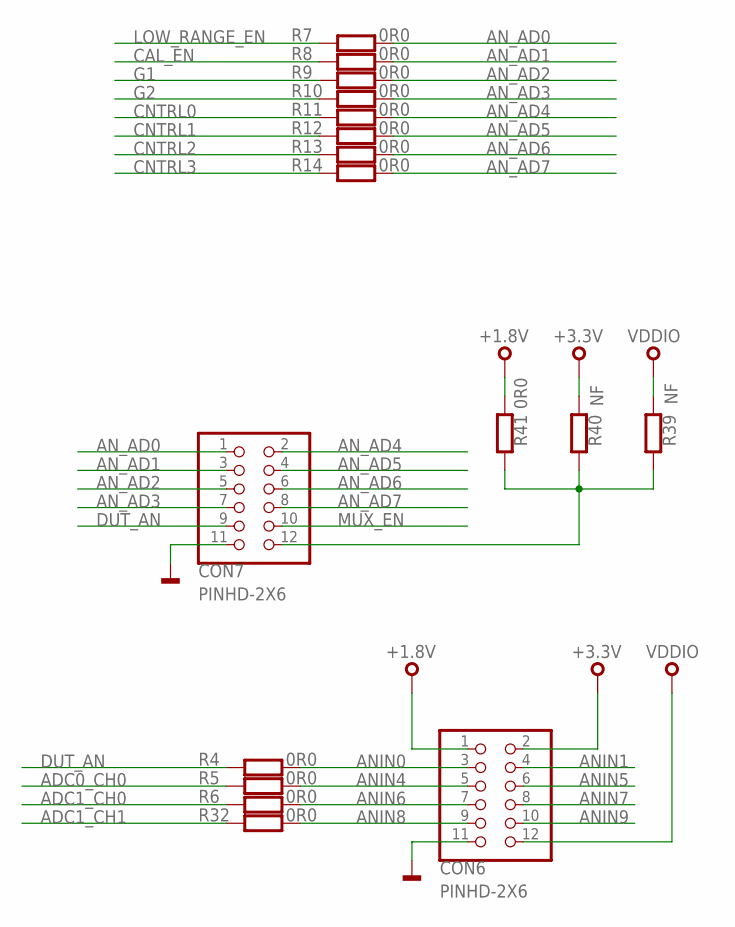
[picture p12: schematic FPGA-Validation.sch, sheet 3]

Parts:
CON6, CON7: PINHD-2X6; 2X06
R4, R5, R6, R7, R8, R9, R10, R11, R12, R13, R14, R32, R41: 0R0; 0603
R39, R40: NF; 0603

Connections:
+1.8V: CON6.1, R41.1; also elsewhere on the board
+3.3V: CON6.2, R40.1; also elsewhere on the board
ADC0_CH0: R5.1; also elsewhere on the board
ADC1_CH0: R6.1; also elsewhere on the board
ADC1_CH1: R32.1; also elsewhere on the board
ANIN0: CON6.3, R4.2; also elsewhere on the board
ANIN1: CON6.4; also elsewhere on the board
ANIN4: CON6.5, R5.2; also elsewhere on the board
ANIN5: CON6.6; also elsewhere on the board
ANIN6: CON6.7, R6.2; also elsewhere on the board
ANIN7: CON6.8; also elsewhere on the board
ANIN8: CON6.9, R32.2; also elsewhere on the board
ANIN9: CON6.10; also elsewhere on the board
AN_AD0: CON7.1, R7.2; also elsewhere on the board
AN_AD1: CON7.3, R8.2; also elsewhere on the board
AN_AD2: CON7.5, R9.2; also elsewhere on the board
AN_AD3: CON7.7, R10.2; also elsewhere on the board
AN_AD4: CON7.2, R11.2; also elsewhere on the board
AN_AD5: CON7.4, R12.2; also elsewhere on the board
AN_AD6: CON7.6, R13.2; also elsewhere on the board
AN_AD7: CON7.8, R14.2; also elsewhere on the board
CAL_EN: R8.1; also elsewhere on the board
CNTRL0: R11.1; also elsewhere on the board
CNTRL1: R12.1; also elsewhere on the board
CNTRL2: R13.1; also elsewhere on the board
CNTRL3: R14.1; also elsewhere on the board
DUT_AN: CON7.9, R4.1; also elsewhere on the board
G1: R9.1; also elsewhere on the board
G2: R10.1; also elsewhere on the board
GND: CON6.11, CON7.11; also elsewhere on the board
LOW_RANGE_EN: R7.1; also elsewhere on the board
MUX_EN: CON7.10; also elsewhere on the board
unnamed: CON7.12, R39.2, R40.2, R41.2
VDDIO: CON6.12, R39.1; also elsewhere on the board

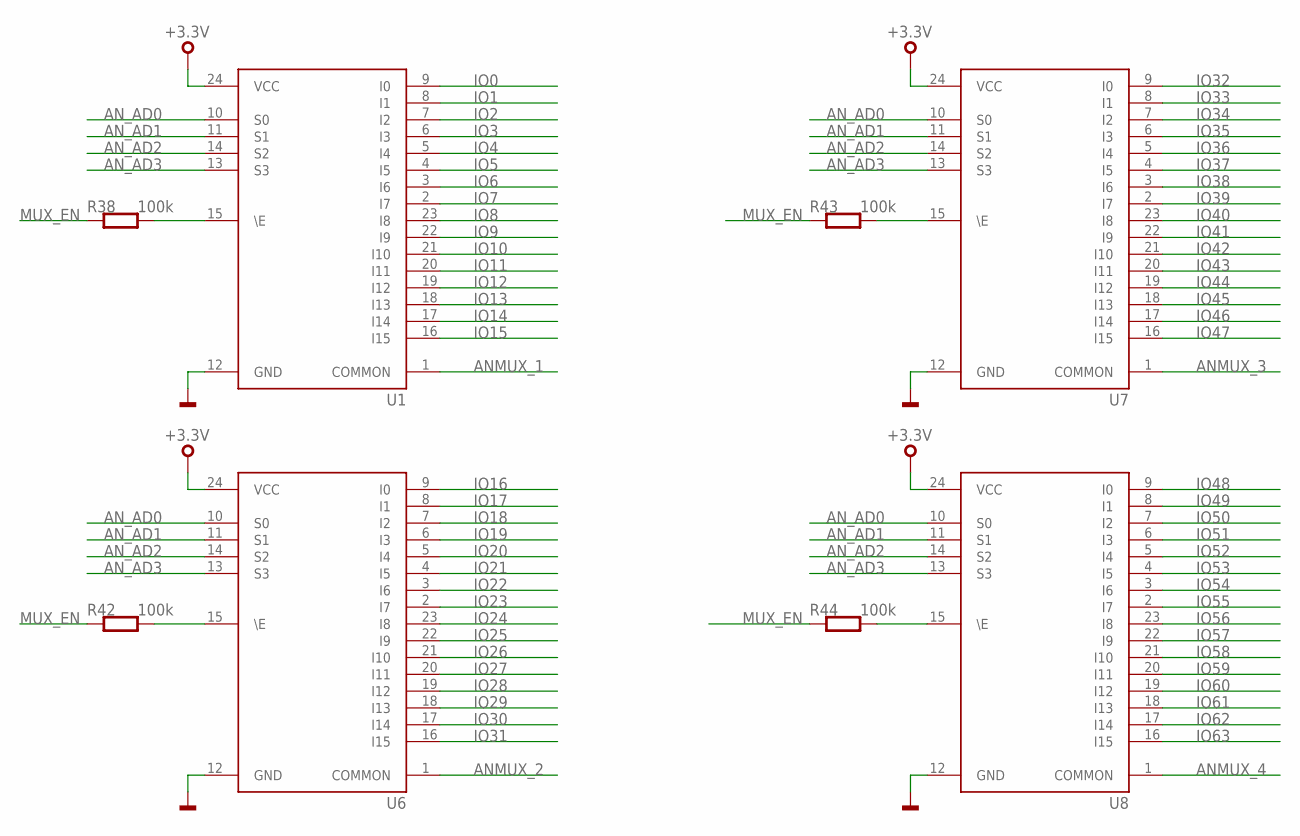
[picture p13: schematic FPGA-Validation.sch, sheet 4]

Parts:
R38, R42, R43, R44: 100k; 0603
U1, U6, U7, U8: CD74HCT4067; SO24

Connections:
+3.3V: U1.24 (VCC), U6.24 (VCC), U7.24 (VCC), U8.24 (VCC); also elsewhere on the board
ANMUX_1: U1.1 (COMMON); also elsewhere on the board
ANMUX_2: U6.1 (COMMON); also elsewhere on the board
ANMUX_3: U7.1 (COMMON); also elsewhere on the board
ANMUX_4: U8.1 (COMMON); also elsewhere on the board
AN_AD0: U1.10 (S0), U6.10 (S0), U7.10 (S0), U8.10 (S0); also elsewhere on the board
AN_AD1: U1.11 (S1), U6.11 (S1), U7.11 (S1), U8.11 (S1); also elsewhere on the board
AN_AD2: U1.14 (S2), U6.14 (S2), U7.14 (S2), U8.14 (S2); also elsewhere on the board
AN_AD3: U1.13 (S3), U6.13 (S3), U7.13 (S3), U8.13 (S3); also elsewhere on the board
GND: U1.12 (GND), U6.12 (GND), U7.12 (GND), U8.12 (GND); also elsewhere on the board
IO0: U1.9 (I0); also elsewhere on the board
IO1: U1.8 (I1); also elsewhere on the board
IO2: U1.7 (I2); also elsewhere on the board
IO3: U1.6 (I3); also elsewhere on the board
IO4: U1.5 (I4); also elsewhere on the board
IO5: U1.4 (I5); also elsewhere on the board
IO6: U1.3 (I6); also elsewhere on the board
IO7: U1.2 (I7); also elsewhere on the board
IO8: U1.23 (I8); also elsewhere on the board
IO9: U1.22 (I9); also elsewhere on the board
IO10: U1.21 (I10); also elsewhere on the board
IO11: U1.20 (I11); also elsewhere on the board
IO12: U1.19 (I12); also elsewhere on the board
IO13: U1.18 (I13); also elsewhere on the board
IO14: U1.17 (I14); also elsewhere on the board
IO15: U1.16 (I15); also elsewhere on the board
IO16: U6.9 (I0); also elsewhere on the board
IO17: U6.8 (I1); also elsewhere on the board
IO18: U6.7 (I2); also elsewhere on the board
IO19: U6.6 (I3); also elsewhere on the board
IO20: U6.5 (I4); also elsewhere on the board
IO21: U6.4 (I5); also elsewhere on the board
IO22: U6.3 (I6); also elsewhere on the board
IO23: U6.2 (I7); also elsewhere on the board
IO24: U6.23 (I8); also elsewhere on the board
IO25: U6.22 (I9); also elsewhere on the board
IO26: U6.21 (I10); also elsewhere on the board
IO27: U6.20 (I11); also elsewhere on the board
IO28: U6.19 (I12); also elsewhere on the board
IO29: U6.18 (I13); also elsewhere on the board
IO30: U6.17 (I14); also elsewhere on the board
IO31: U6.16 (I15); also elsewhere on the board
IO32: U7.9 (I0); also elsewhere on the board
IO33: U7.8 (I1); also elsewhere on the board
IO34: U7.7 (I2); also elsewhere on the board
IO35: U7.6 (I3); also elsewhere on the board
IO36: U7.5 (I4); also elsewhere on the board
IO37: U7.4 (I5); also elsewhere on the board
IO38: U7.3 (I6); also elsewhere on the board
IO39: U7.2 (I7); also elsewhere on the board
IO40: U7.23 (I8); also elsewhere on the board
IO41: U7.22 (I9); also elsewhere on the board
IO42: U7.21 (I10); also elsewhere on the board
IO43: U7.20 (I11); also elsewhere on the board
IO44: U7.19 (I12); also elsewhere on the board
IO45: U7.18 (I13); also elsewhere on the board
IO46: U7.17 (I14); also elsewhere on the board
IO47: U7.16 (I15); also elsewhere on the board
IO48: U8.9 (I0); also elsewhere on the board
IO49: U8.8 (I1); also elsewhere on the board
IO50: U8.7 (I2); also elsewhere on the board
IO51: U8.6 (I3); also elsewhere on the board
IO52: U8.5 (I4); also elsewhere on the board
IO53: U8.4 (I5); also elsewhere on the board
IO54: U8.3 (I6); also elsewhere on the board
IO55: U8.2 (I7); also elsewhere on the board
IO56: U8.23 (I8); also elsewhere on the board
IO57: U8.22 (I9); also elsewhere on the board
IO58: U8.21 (I10); also elsewhere on the board
IO59: U8.20 (I11); also elsewhere on the board
IO60: U8.19 (I12); also elsewhere on the board
IO61: U8.18 (I13); also elsewhere on the board
IO62: U8.17 (I14); also elsewhere on the board
IO63: U8.16 (I15); also elsewhere on the board
MUX_EN: R38.1, R42.1, R43.1, R44.1; also elsewhere on the board
unnamed: R42.2, U6.15 (\E)
unnamed: R43.2, U7.15 (\E)
unnamed: R38.2, U1.15 (\E)
unnamed: R44.2, U8.15 (\E)

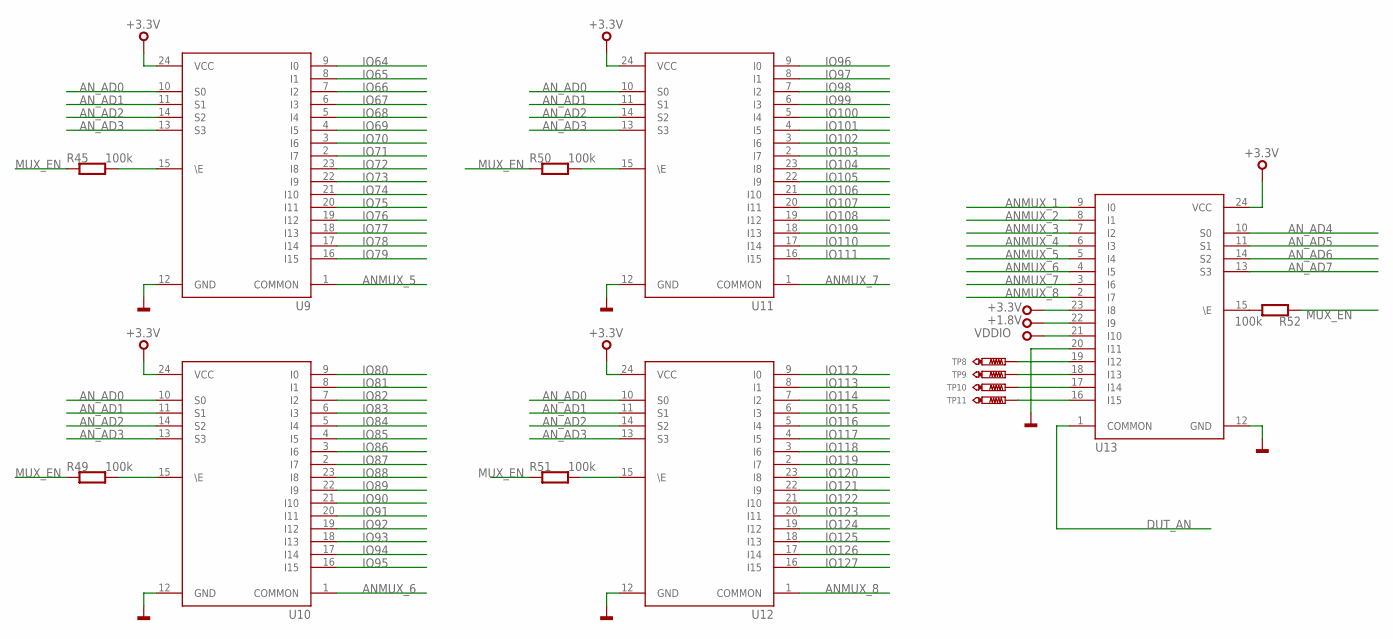
[picture p14: schematic FPGA-Validation.sch, sheet 5]

Parts:
R45, R49, R50, R51, R52: 100k; 0603
TP8, TP9, TP10, TP11: TEST_POINT-50R-PTH; TP50-PTH
U9, U10, U11, U12, U13: CD74HCT4067; SO24

Connections:
+1.8V: U13.22 (I9); also elsewhere on the board
+3.3V: U9.24 (VCC), U10.24 (VCC), U11.24 (VCC), U12.24 (VCC), U13.23 (I8), U13.24 (VCC); also elsewhere on the board
ANMUX_1: U13.9 (I0); also elsewhere on the board
ANMUX_2: U13.8 (I1); also elsewhere on the board
ANMUX_3: U13.7 (I2); also elsewhere on the board
ANMUX_4: U13.6 (I3); also elsewhere on the board
ANMUX_5: U9.1 (COMMON), U13.5 (I4)
ANMUX_6: U10.1 (COMMON), U13.4 (I5)
ANMUX_7: U11.1 (COMMON), U13.3 (I6)
ANMUX_8: U12.1 (COMMON), U13.2 (I7)
AN_AD0: U9.10 (S0), U10.10 (S0), U11.10 (S0), U12.10 (S0); also elsewhere on the board
AN_AD1: U9.11 (S1), U10.11 (S1), U11.11 (S1), U12.11 (S1); also elsewhere on the board
AN_AD2: U9.14 (S2), U10.14 (S2), U11.14 (S2), U12.14 (S2); also elsewhere on the board
AN_AD3: U9.13 (S3), U10.13 (S3), U11.13 (S3), U12.13 (S3); also elsewhere on the board
AN_AD4: U13.10 (S0); also elsewhere on the board
AN_AD5: U13.11 (S1); also elsewhere on the board
AN_AD6: U13.14 (S2); also elsewhere on the board
AN_AD7: U13.13 (S3); also elsewhere on the board
DUT_AN: U13.1 (COMMON); also elsewhere on the board
GND: U9.12 (GND), U10.12 (GND), U11.12 (GND), U12.12 (GND), U13.12 (GND), U13.20 (I11); also elsewhere on the board
IO64: U9.9 (I0); also elsewhere on the board
IO65: U9.8 (I1); also elsewhere on the board
IO66: U9.7 (I2); also elsewhere on the board
IO67: U9.6 (I3); also elsewhere on the board
IO68: U9.5 (I4); also elsewhere on the board
IO69: U9.4 (I5); also elsewhere on the board
IO70: U9.3 (I6); also elsewhere on the board
IO71: U9.2 (I7); also elsewhere on the board
IO72: U9.23 (I8); also elsewhere on the board
IO73: U9.22 (I9); also elsewhere on the board
IO74: U9.21 (I10); also elsewhere on the board
IO75: U9.20 (I11); also elsewhere on the board
IO76: U9.19 (I12); also elsewhere on the board
IO77: U9.18 (I13); also elsewhere on the board
IO78: U9.17 (I14); also elsewhere on the board
IO79: U9.16 (I15); also elsewhere on the board
IO80: U10.9 (I0); also elsewhere on the board
IO81: U10.8 (I1); also elsewhere on the board
IO82: U10.7 (I2); also elsewhere on the board
IO83: U10.6 (I3); also elsewhere on the board
IO84: U10.5 (I4); also elsewhere on the board
IO85: U10.4 (I5); also elsewhere on the board
IO86: U10.3 (I6); also elsewhere on the board
IO87: U10.2 (I7); also elsewhere on the board
IO88: U10.23 (I8); also elsewhere on the board
IO89: U10.22 (I9); also elsewhere on the board
IO90: U10.21 (I10); also elsewhere on the board
IO91: U10.20 (I11); also elsewhere on the board
IO92: U10.19 (I12); also elsewhere on the board
IO93: U10.18 (I13); also elsewhere on the board
IO94: U10.17 (I14); also elsewhere on the board
IO95: U10.16 (I15); also elsewhere on the board
IO96: U11.9 (I0); also elsewhere on the board
IO97: U11.8 (I1); also elsewhere on the board
IO98: U11.7 (I2); also elsewhere on the board
IO99: U11.6 (I3); also elsewhere on the board
IO100: U11.5 (I4); also elsewhere on the board
IO101: U11.4 (I5); also elsewhere on the board
IO102: U11.3 (I6); also elsewhere on the board
IO103: U11.2 (I7); also elsewhere on the board
IO104: U11.23 (I8); also elsewhere on the board
IO105: U11.22 (I9); also elsewhere on the board
IO106: U11.21 (I10); also elsewhere on the board
IO107: U11.20 (I11); also elsewhere on the board
IO108: U11.19 (I12); also elsewhere on the board
IO109: U11.18 (I13); also elsewhere on the board
IO110: U11.17 (I14); also elsewhere on the board
IO111: U11.16 (I15); also elsewhere on the board
IO112: U12.9 (I0); also elsewhere on the board
IO113: U12.8 (I1); also elsewhere on the board
IO114: U12.7 (I2); also elsewhere on the board
IO115: U12.6 (I3); also elsewhere on the board
IO116: U12.5 (I4); also elsewhere on the board
IO117: U12.4 (I5); also elsewhere on the board
IO118: U12.3 (I6); also elsewhere on the board
IO119: U12.2 (I7); also elsewhere on the board
IO120: U12.23 (I8); also elsewhere on the board
IO121: U12.22 (I9); also elsewhere on the board
IO122: U12.21 (I10); also elsewhere on the board
IO123: U12.20 (I11); also elsewhere on the board
IO124: U12.19 (I12); also elsewhere on the board
IO125: U12.18 (I13); also elsewhere on the board
IO126: U12.17 (I14); also elsewhere on the board
IO127: U12.16 (I15); also elsewhere on the board
MUX_EN: R45.1, R49.1, R50.1, R51.1, R52.1; also elsewhere on the board
unnamed: R45.2, U9.15 (\E)
unnamed: R49.2, U10.15 (\E)
unnamed: R50.2, U11.15 (\E)
unnamed: R51.2, U12.15 (\E)
unnamed: R52.2, U13.15 (\E)
unnamed: TP8.TP, U13.19 (I12)
unnamed: TP9.TP, U13.18 (I13)
unnamed: TP10.TP, U13.17 (I14)
unnamed: TP11.TP, U13.16 (I15)
VDDIO: U13.21 (I10); also elsewhere on the board

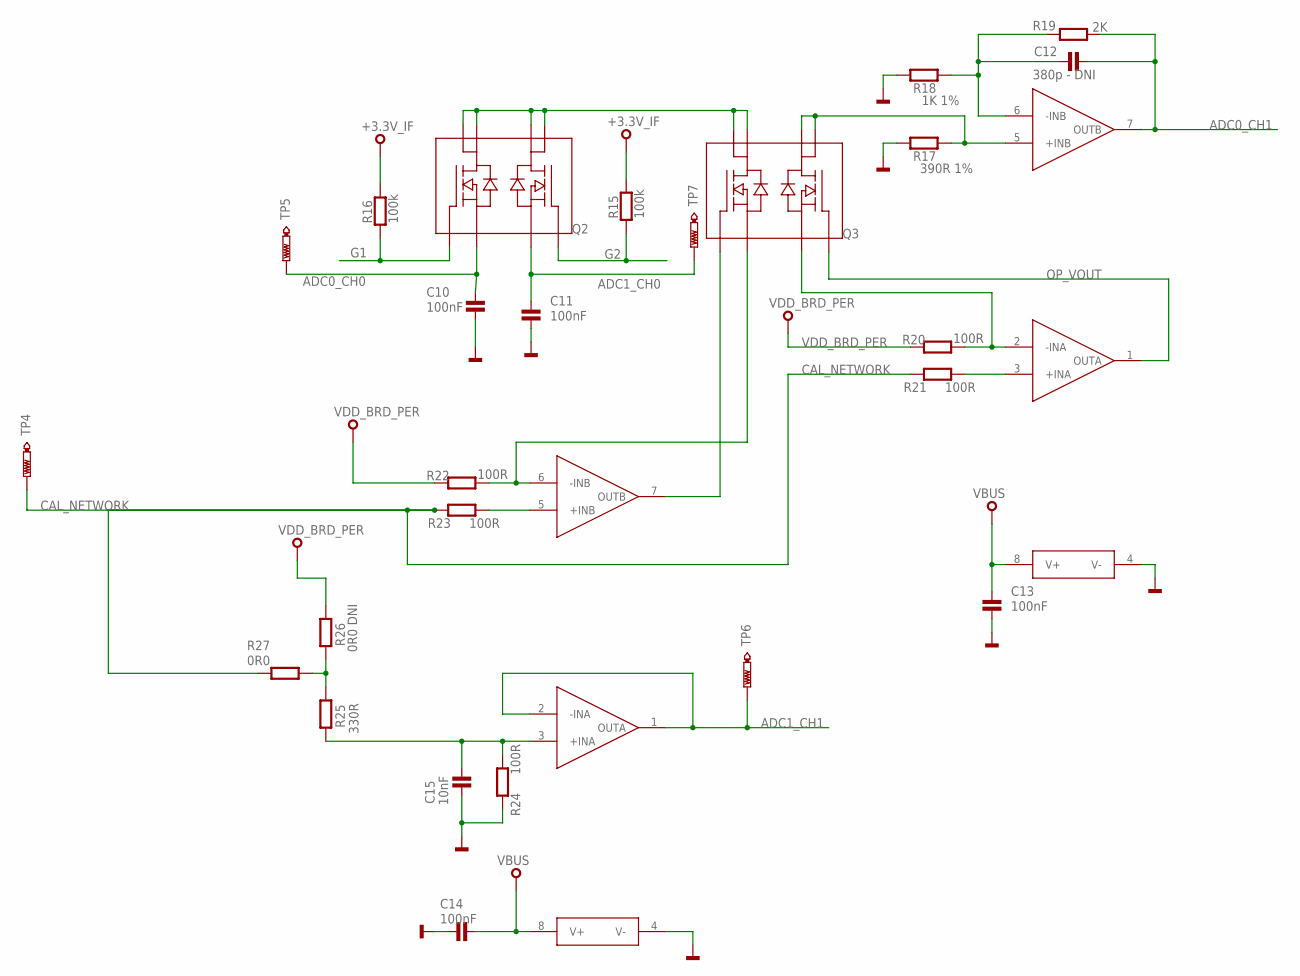
[picture p15: schematic FPGA-Validation.sch, sheet 6]

Parts:
C10, C11, C13, C14: 100nF; 0603
C12: 380p - DNI; 0603
C15: 10nF; 0603
Q2, Q3: PMDPB55XP; SOT1118
R15, R16: 100k; 0603@1
R17: 390R 1%; 0603@1
R18: 1K 1%; 0603@1
R19: 2K; 0603@1
R20, R21, R22, R23, R24: 100R; 0603@1
R25: 330R; 0603@1
R26: 0R0 DNI; 0603@1
R27: 0R0; 0603@1
TP4, TP5, TP6, TP7: TEST-POINT-50R-PTH; TP50-PTH
U2, U3: LTC2051IMS8; MSOP8

Connections:
+3.3V_IF: R15.2, R16.2
ADC0_CH0: C10.1, Q2.3 (D2A), TP5.TP; also elsewhere on the board
ADC0_CH1: C12.2, R19.1, U3.7 (OUTB)
ADC1_CH0: C11.1, Q2.7 (D1B), TP7.TP; also elsewhere on the board
ADC1_CH1: TP6.TP, U2.1 (OUTA), U2.2 (-INA); also elsewhere on the board
CAL_NETWORK: R21.2, R23.2, R27.1, TP4.TP; also elsewhere on the board
G1: Q2.8 (D2B), R16.1; also elsewhere on the board
G2: Q2.6 (D1A), R15.1; also elsewhere on the board
GND: C10.2, C11.2, C13.2, C14.2, C15.2, R17.2, R18.2, R24.2, U2.4 (V-), U3.4 (V-); also elsewhere on the board
unnamed: Q2.1 (S1), Q2.2 (G1), Q2.4 (S2), Q2.5 (G2), Q3.4 (S2), Q3.5 (G2)
unnamed: Q3.1 (S1), Q3.2 (G1), R17.1, U3.5 (+INB)
unnamed: C12.1, R18.1, R19.2, U3.6 (-INB)
unnamed: Q3.7 (D1B), R20.1, U3.2 (-INA)
unnamed: R21.1, U3.3 (+INA)
unnamed: Q3.3 (D2A), R22.1, U2.6 (-INB)
unnamed: R23.1, U2.5 (+INB)
unnamed: Q3.8 (D2B), U2.7 (OUTB)
unnamed: C15.1, R24.1, R25.2, U2.3 (+INA)
unnamed: R25.1, R26.2, R27.2
OP_VOUT: Q3.6 (D1A), U3.1 (OUTA)
VBUS: C13.1, C14.1, U2.8 (V+), U3.8 (V+)
VDD_BRD_PER: R20.2, R22.2, R26.1; also elsewhere on the board

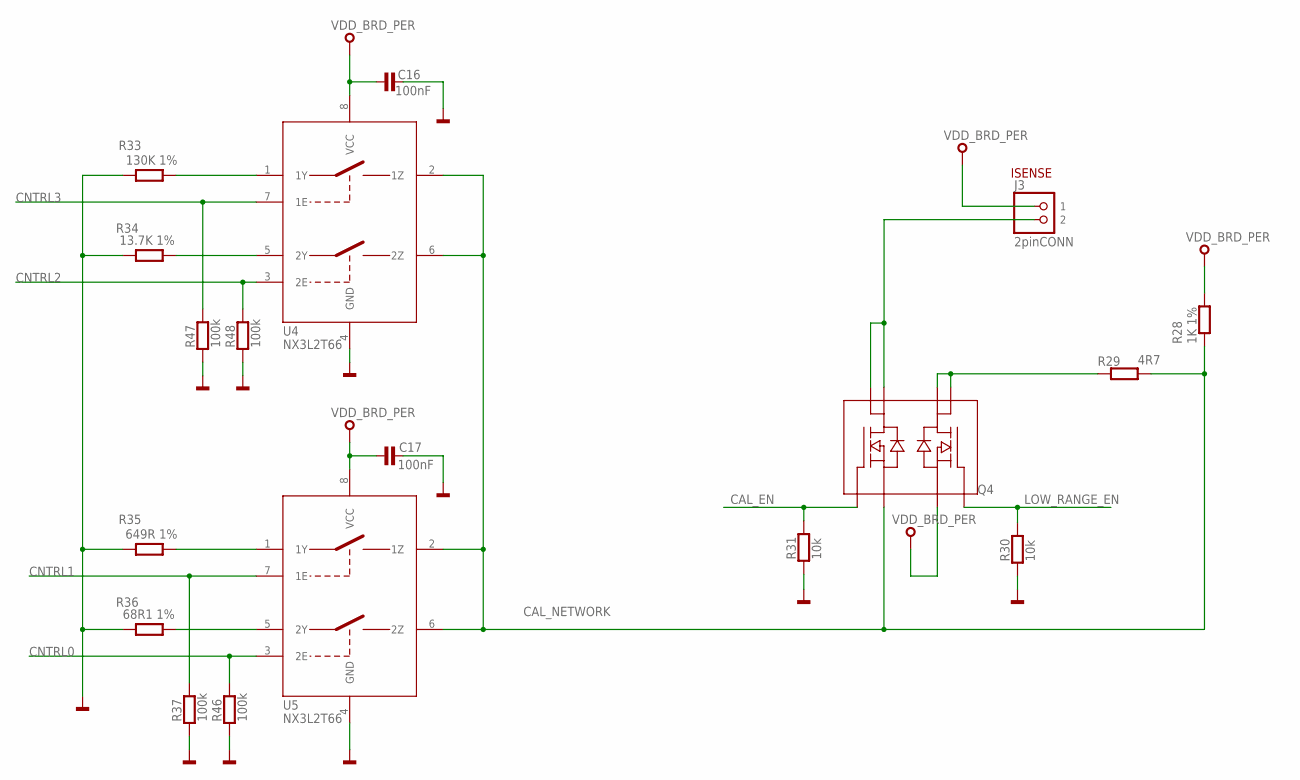
[picture p16: schematic FPGA-Validation.sch, sheet 7]

Parts:
C16, C17: 100nF; 0603
J3: 2pinCONN; 1X02
Q4: PMDPB55XP; SOT1118
R28: 1K 1%; 0603@1
R29: 4R7; 0603@1
R30, R31: 10k; 0603@1
R33: 130K 1%; 0603@1
R34: 13.7K 1%; 0603@1
R35: 649R 1%; 0603@1
R36: 68R1 1%; 0603@1
R37, R46, R47, R48: 100k; 0603@1
U4, U5: NX3L2T66; XSON8

Connections:
CAL_EN: Q4.8 (D2B), R31.2; also elsewhere on the board
CAL_NETWORK: Q4.3 (D2A), R28.1, R29.1, U4.2 (1Z), U4.6 (2Z), U5.2 (1Z), U5.6 (2Z); also elsewhere on the board
CNTRL0: R46.2, U5.3 (2E); also elsewhere on the board
CNTRL1: R37.2, U5.7 (1E); also elsewhere on the board
CNTRL2: R48.2, U4.3 (2E); also elsewhere on the board
CNTRL3: R47.2, U4.7 (1E); also elsewhere on the board
GND: C16.1, C17.1, R30.1, R31.1, R33.2, R34.2, R35.2, R36.2, R37.1, R46.1, R47.1, R48.1, U4.4 (GND), U5.4 (GND); also elsewhere on the board
LOW_RANGE_EN: Q4.6 (D1A), R30.2; also elsewhere on the board
unnamed: J3.2, Q4.4 (S2), Q4.5 (G2)
unnamed: Q4.1 (S1), Q4.2 (G1), R29.2
unnamed: R33.1, U4.1 (1Y)
unnamed: R34.1, U4.5 (2Y)
unnamed: R35.1, U5.1 (1Y)
unnamed: R36.1, U5.5 (2Y)
VDD_BRD_PER: C16.2, C17.2, J3.1, Q4.7 (D1B), R28.2, U4.8 (VCC), U5.8 (VCC); also elsewhere on the board

Notes on the sheet:
ISENSE

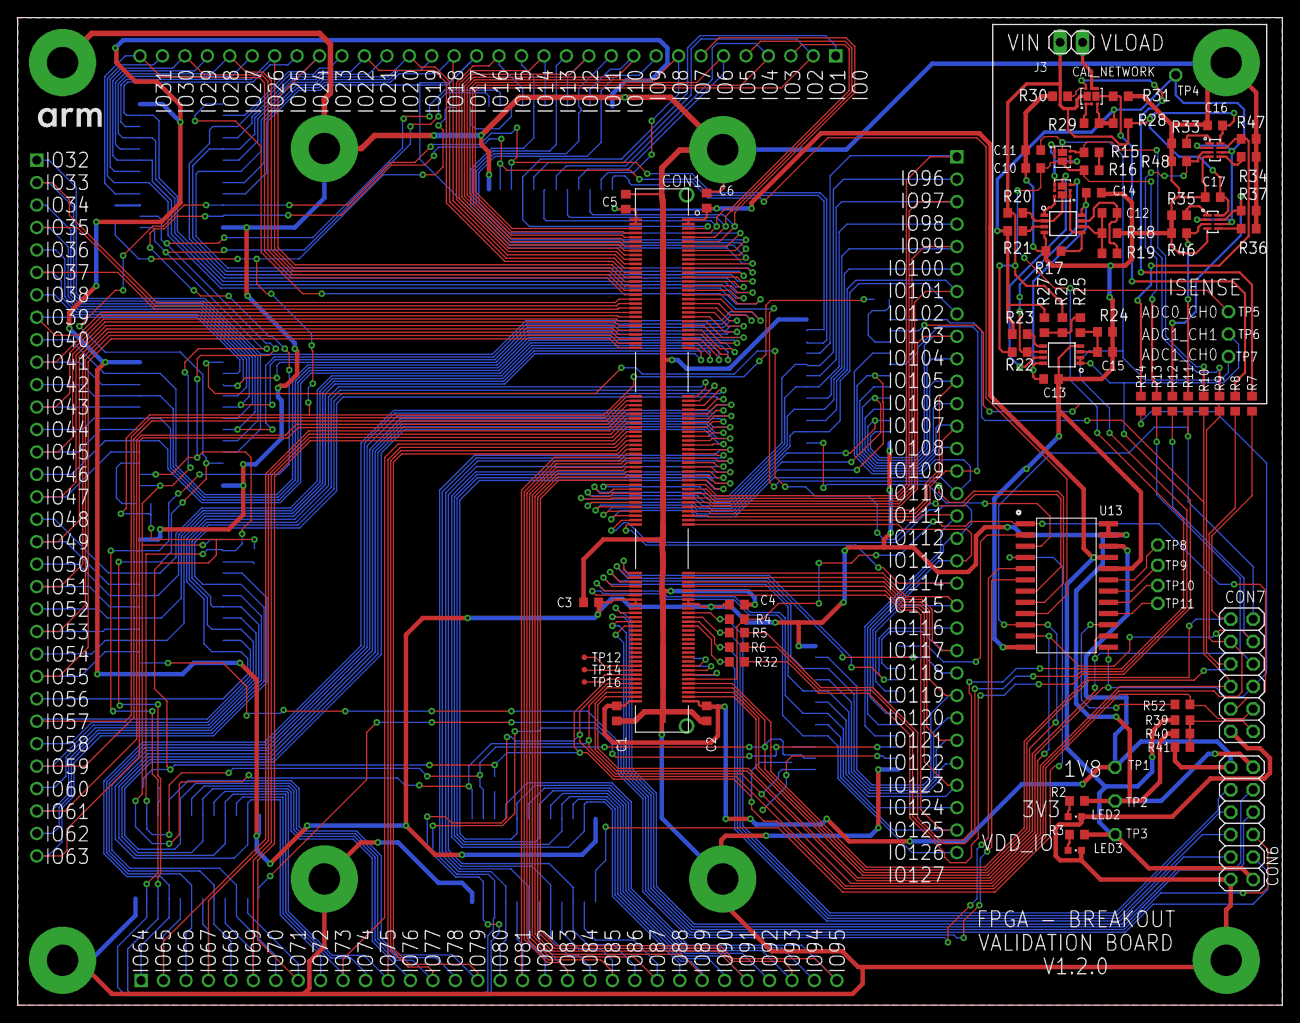
[picture p17: board FPGA-Validation.brd from above]

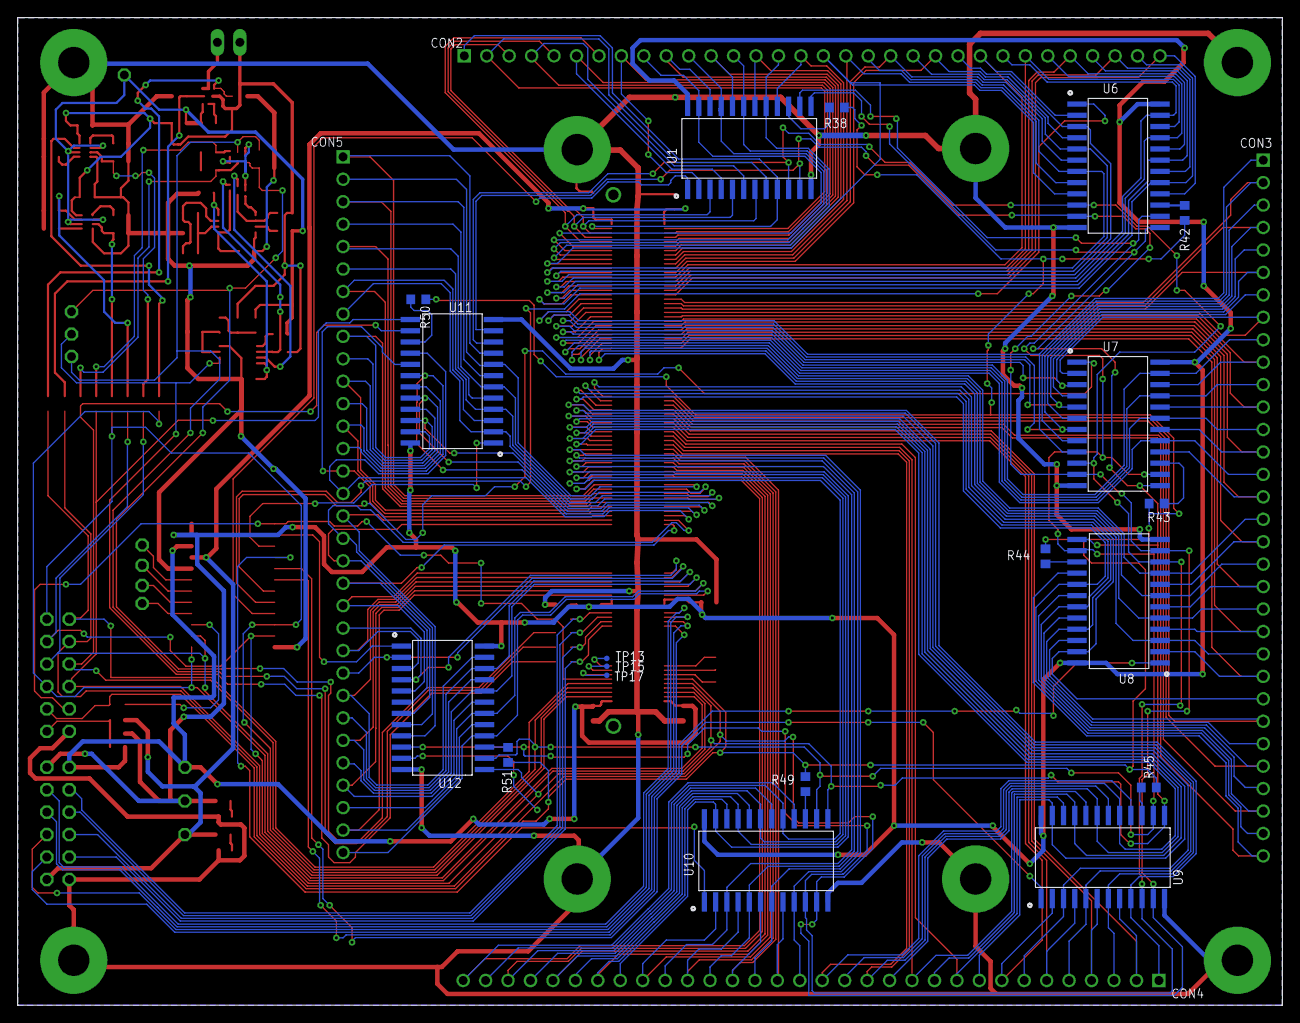
[picture p18: board FPGA-Validation.brd from below]

Board: 2 copper layers, 143.1 x 111.8 mm, 116 parts (19 on the bottom side), 213 nets.
